JorgeFernandes-Git/ISFM/GUI_ISFM_VisualBasic/GUI RRplano/bin/Debug/img/full-moon.png

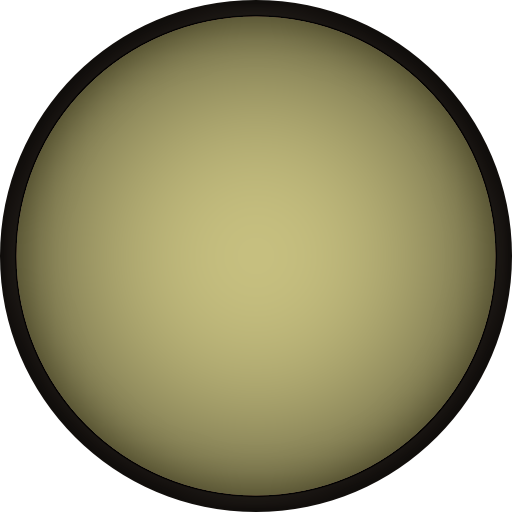
GUI_ISFM_VisualBasic/GUI RRplano/bin/Debug/img/full-moon.png
