JorgeFernandes-Git/ISFM/README.md

# ISFM
Project of the electrical enclosure, motor selection, and programming of the inverse kinematics of an incremental sheet forming machine based on an RR plane robotic arm.

CURRENT VERSIONS

- Final4.0_HK for Arduino
- GUI_ISFM_VisualBasic for sending commands from the computer

Author: Jorge Fernandes 104580
