JorgeFernandes-Git/ISFM/GUI_ISFM_VisualBasic/GUI RRplano/Resources/download.jpg

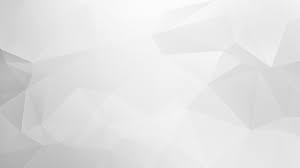
GUI_ISFM_VisualBasic/GUI RRplano/Resources/download.jpg
