JorgeFernandes-Git/ISFM/Electrical_Enclosure_ISFM.pdf

E | E
F | F

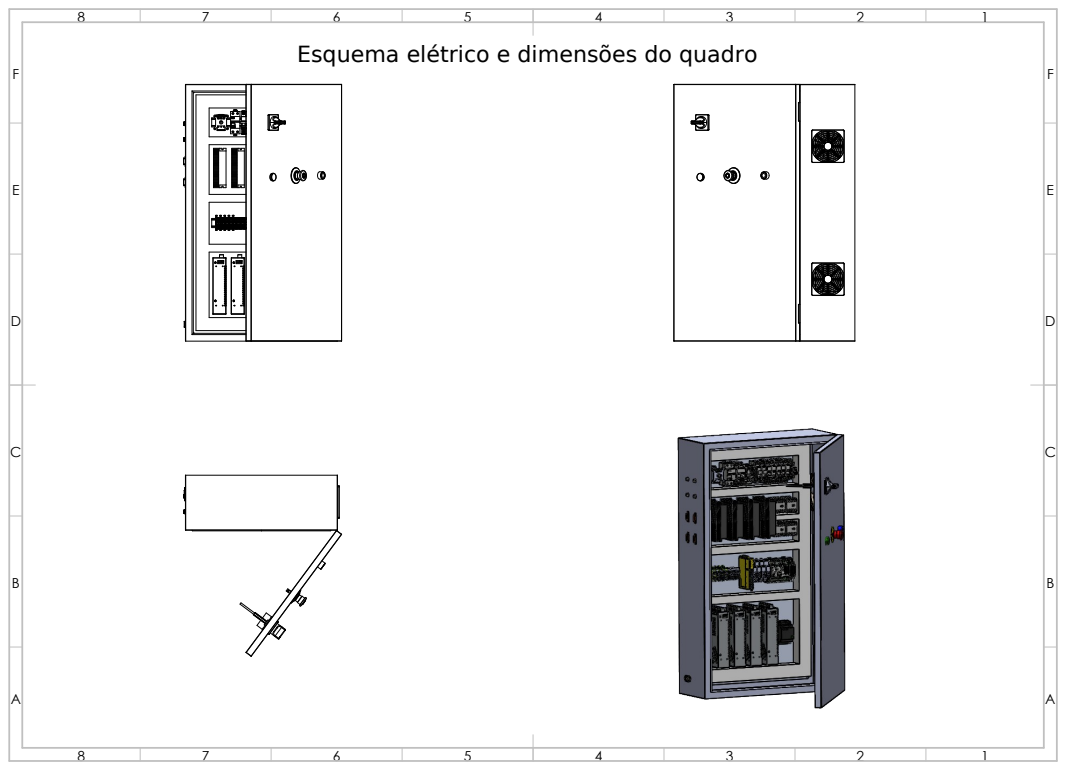
[picture p3: page 1]

Esquema elétrico e dimensões do quadro

1234

5

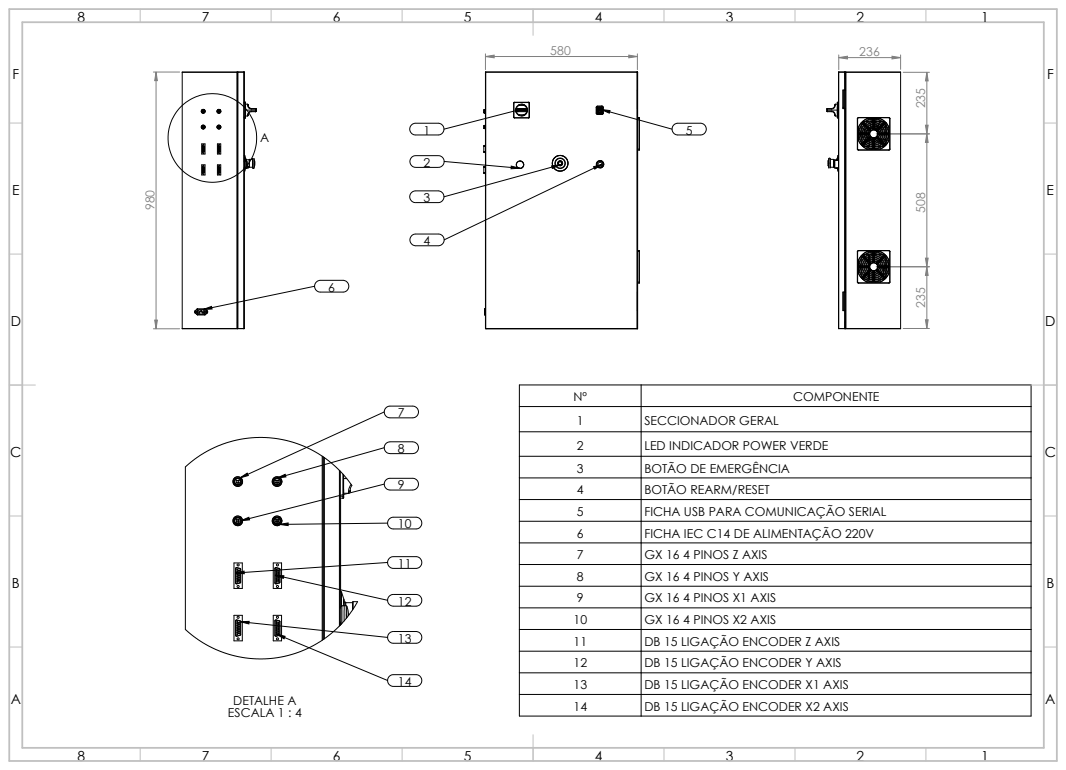
[picture p4: page 2]
DETALHE A ESCALA 1 : 4; COMPONENTE 1; SECCIONADOR GERAL 2; LED INDICADOR POWER VERDE 3; BOTÃO DE EMERGÊNCIA 4; BOTÃO REARM/RESET 5; FICHA USB PARA COMUNICAÇÃO SERIAL 6; FICHA IEC C14 DE ALIMENTAÇÃO 220V 7; GX 16 4 PINOS Z AXIS 8; GX 16 4 PINOS Y AXIS 9; GX 16 4 PINOS X1 AXIS

10 | GX 16 4 PINOS X2 AXIS
11 | DB 15 LIGAÇÃO ENCODER Z AXIS
12 | DB 15 LIGAÇÃO ENCODER Y AXIS
13 | DB 15 LIGAÇÃO ENCODER X1 AXIS
14 | DB 15 LIGAÇÃO ENCODER X2 AXIS

1 | 2 | 3 | 4 | 5 | 6 | 7 | 8 | 9
| | | | | | | | 10

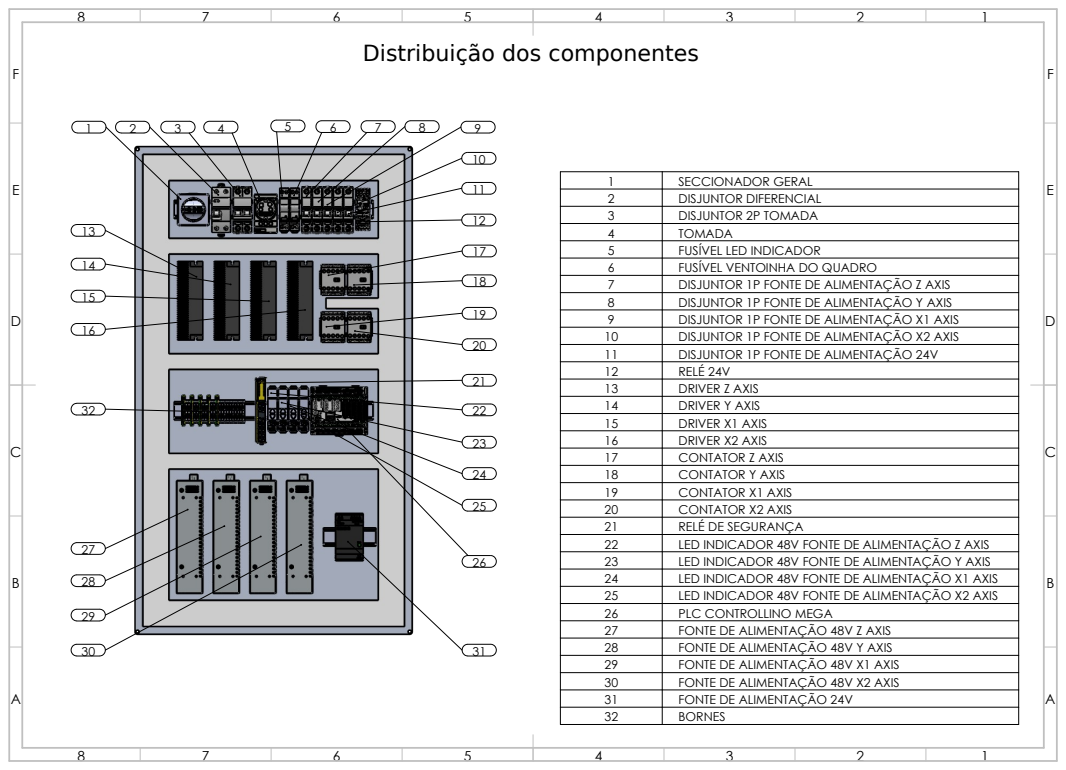
[picture p5: page 3]
RELÉ DE SEGURANÇA

Distribuição dos componentes

1 | SECCIONADOR GERAL
2 | DISJUNTOR DIFERENCIAL
3 | DISJUNTOR 2P TOMADA
4 | TOMADA
5 | FUSÍVEL LED INDICADOR
6 | FUSÍVEL VENTOINHA DO QUADRO
7 | DISJUNTOR 1P FONTE DE ALIMENTAÇÃO Z AXIS
8 | DISJUNTOR 1P FONTE DE ALIMENTAÇÃO Y AXIS
9 | DISJUNTOR 1P FONTE DE ALIMENTAÇÃO X1 AXIS
10 | DISJUNTOR 1P FONTE DE ALIMENTAÇÃO X2 AXIS
11 | DISJUNTOR 1P FONTE DE ALIMENTAÇÃO 24V
12 | RELÉ 24V
13 | DRIVER Z AXIS
14 | DRIVER Y AXIS
15 | DRIVER X1 AXIS
16 | DRIVER X2 AXIS
17 | CONTATOR Z AXIS
18 | CONTATOR Y AXIS
19 | CONTATOR X1 AXIS
20 | CONTATOR X2 AXIS

22 | LED INDICADOR 48V FONTE DE ALIMENTAÇÃO Z AXIS
23 | LED INDICADOR 48V FONTE DE ALIMENTAÇÃO Y AXIS
24 | LED INDICADOR 48V FONTE DE ALIMENTAÇÃO X1 AXIS
25 | LED INDICADOR 48V FONTE DE ALIMENTAÇÃO X2 AXIS
26 | PLC CONTROLLINO MEGA
27 | FONTE DE ALIMENTAÇÃO 48V Z AXIS
28 | FONTE DE ALIMENTAÇÃO 48V Y AXIS
29 | FONTE DE ALIMENTAÇÃO 48V X1 AXIS
30 | FONTE DE ALIMENTAÇÃO 48V X2 AXIS
31 | FONTE DE ALIMENTAÇÃO 24V
32 | BORNES

380.00
70

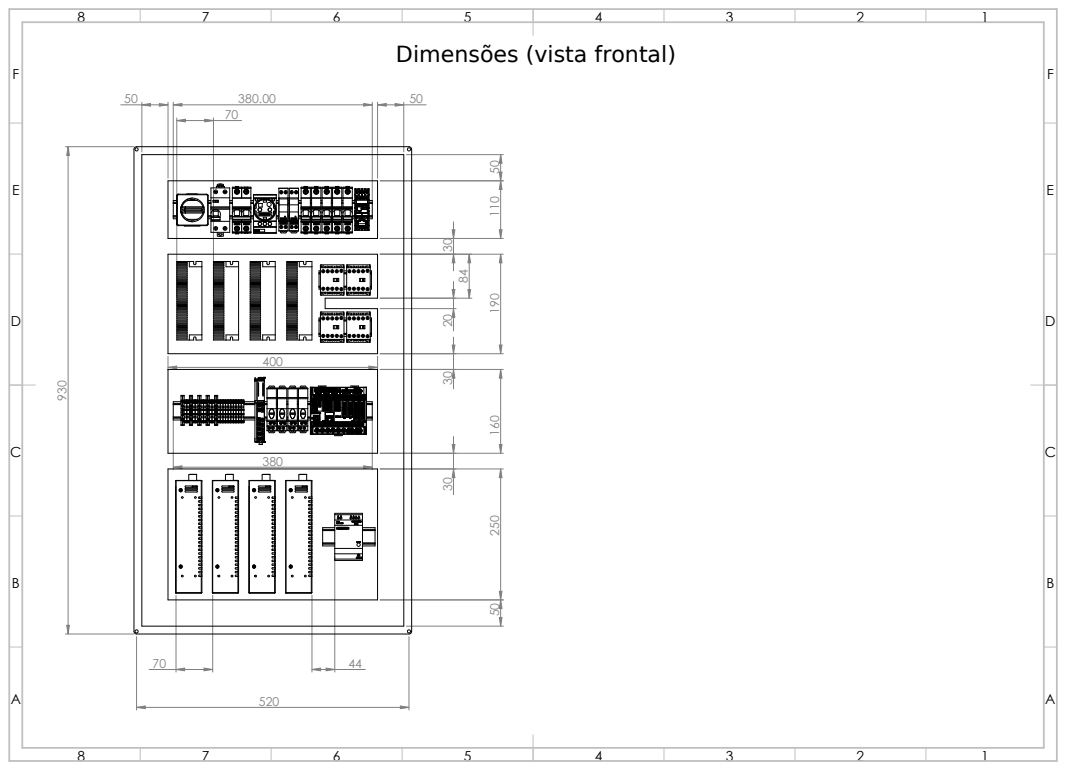
[picture p6: page 4]

Dimensões (vista frontal)

# Esquema de Potência 1

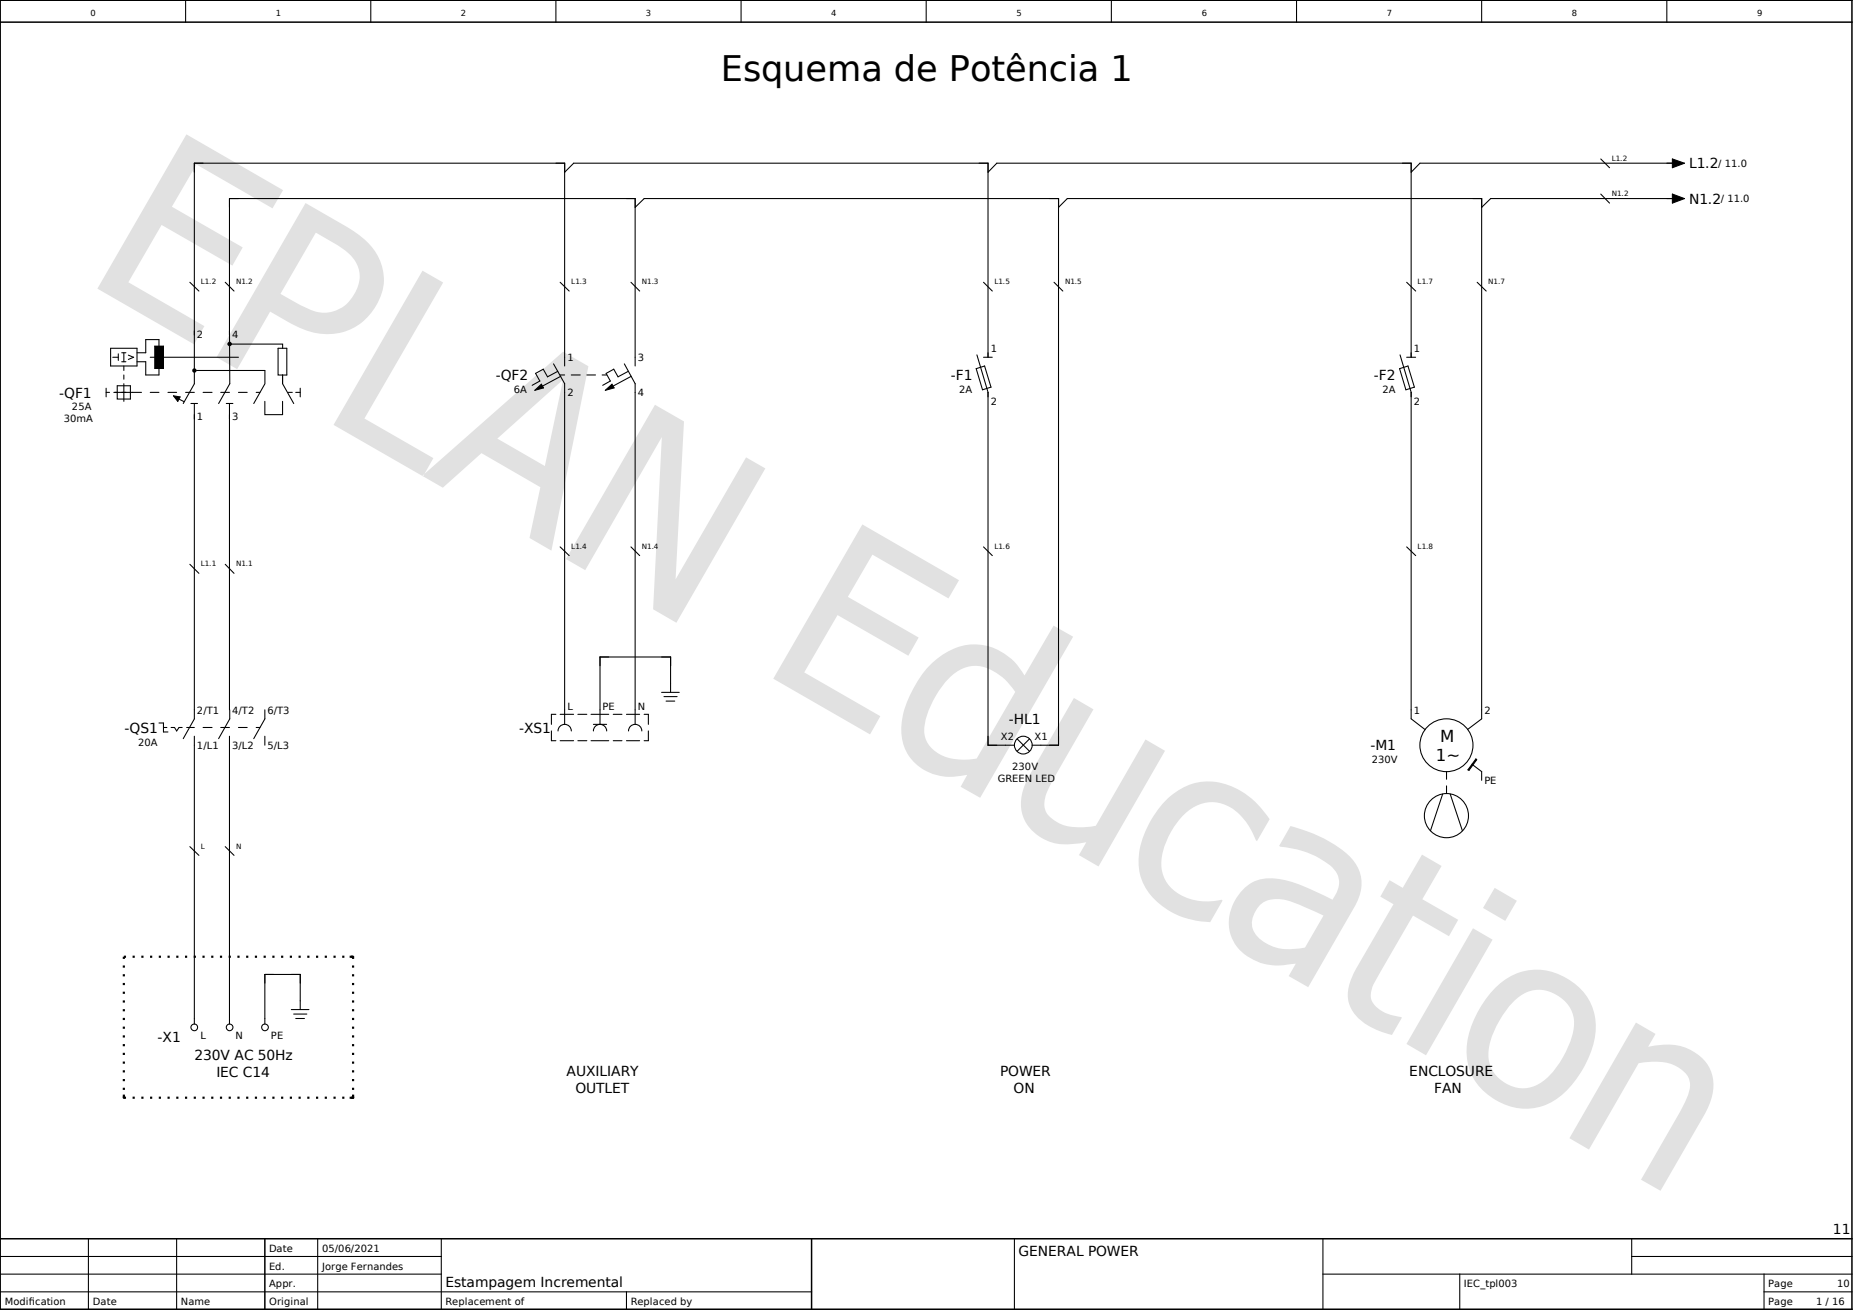
[picture p7: page 5]
IEC C14; AUXILIARY; OUTLET; ENCLOSURE FAN; POWER ON; 230V GREEN LED

Estampagem Incremental | GENERAL POWER

Ed. | Jorge Fernandes
Appr. | | | | IEC_tpl003 | Page

Modification | Date | Name | Original | | Replacement of | Replaced by

# Esquema de Potência 2

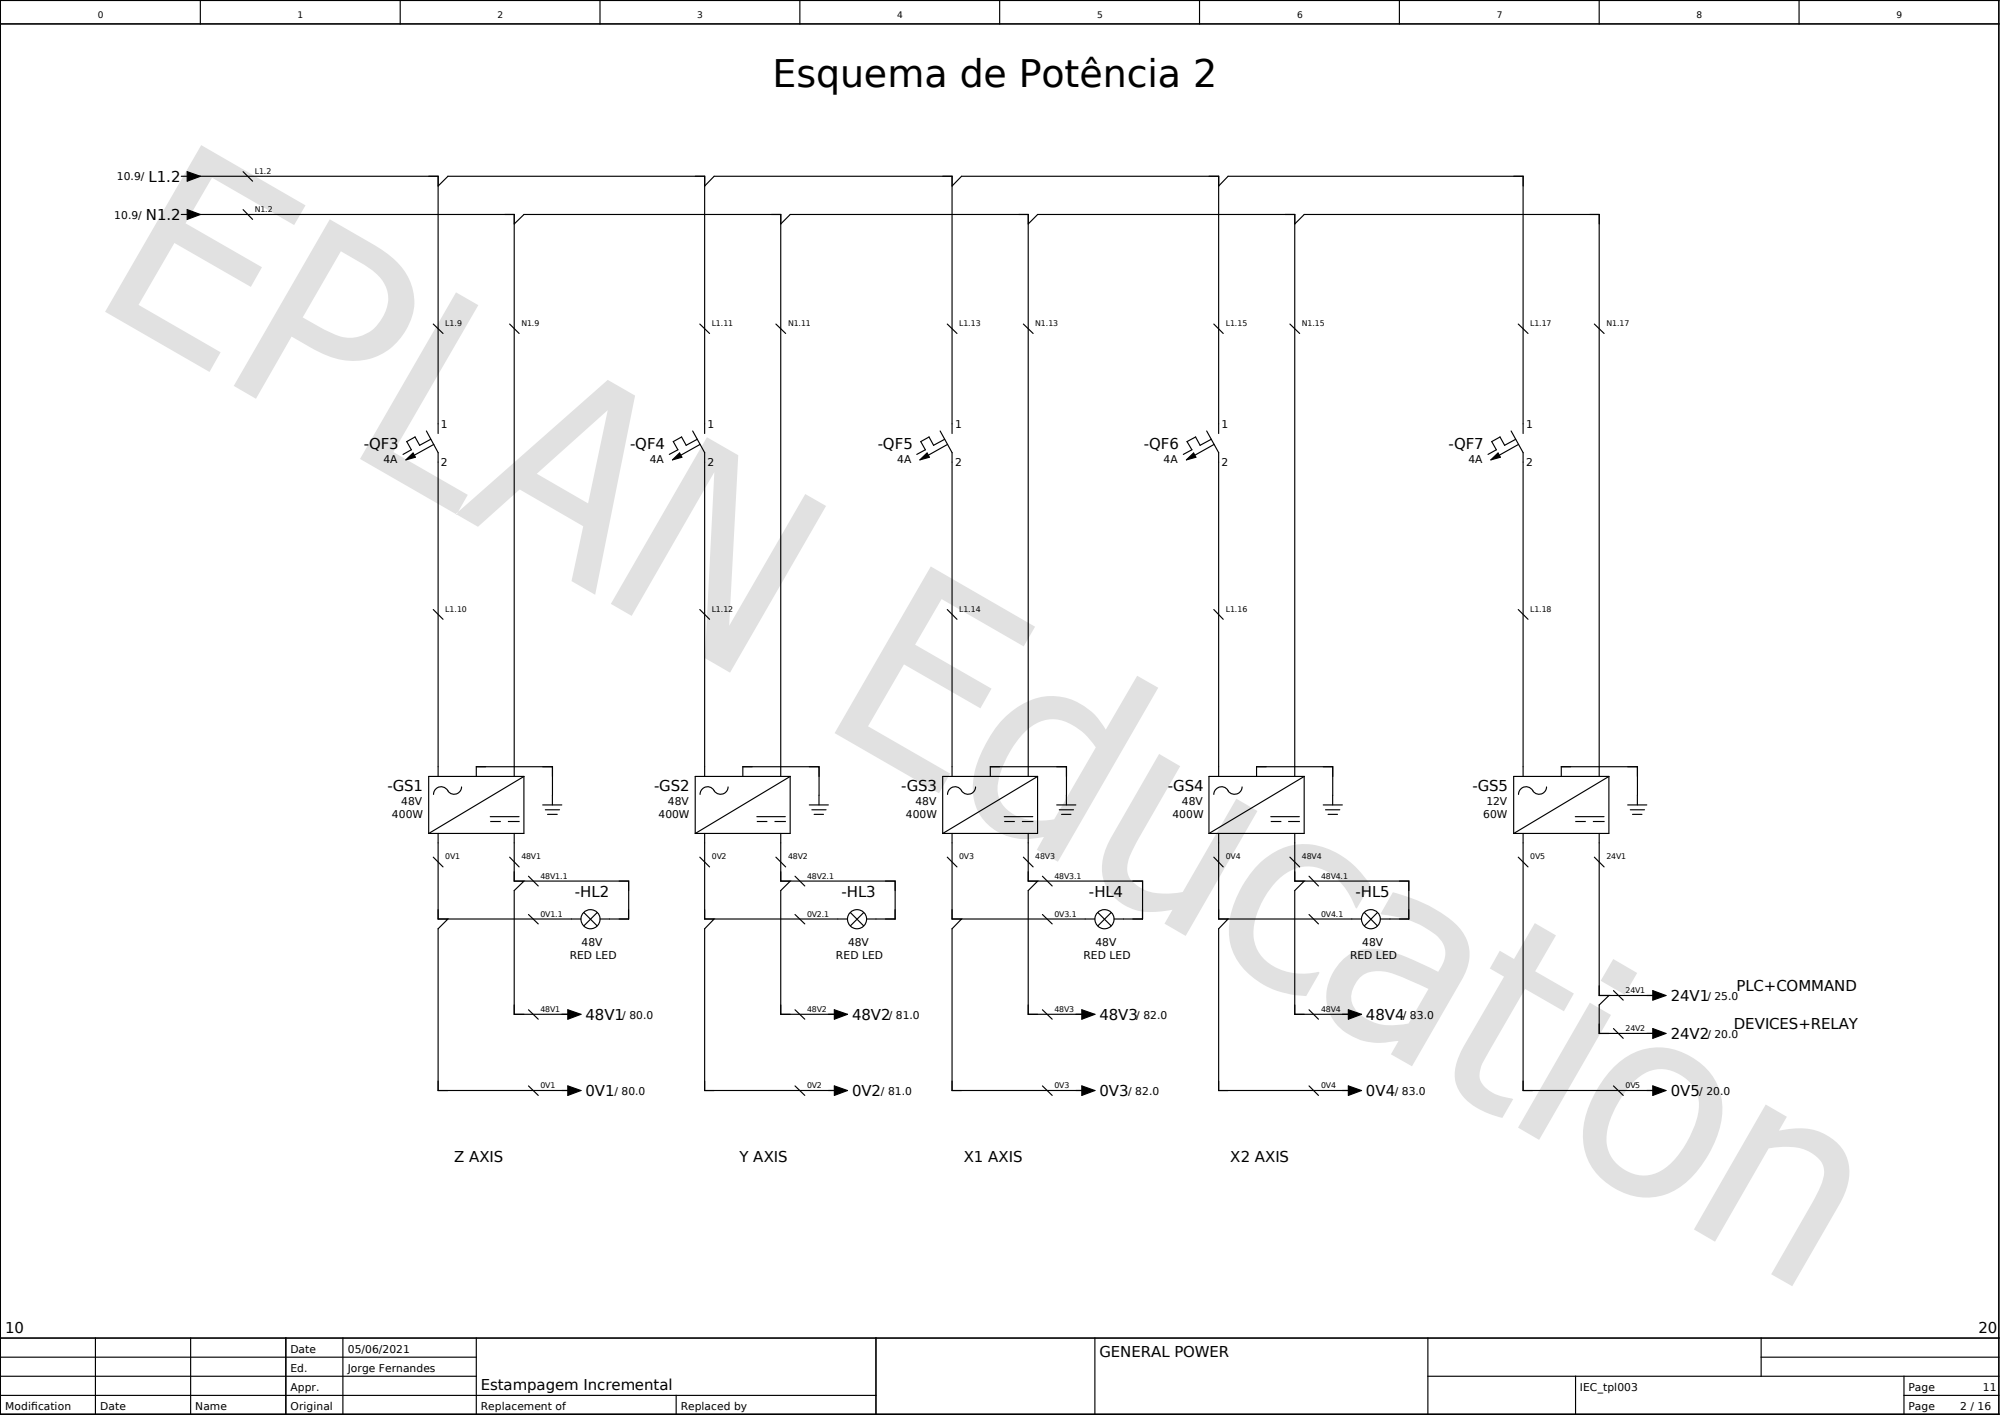
[picture p8: page 6]
GENERAL POWER; Z AXIS; Y AXIS; X1 AXIS; X2 AXIS; PLC+COMMAND; DEVICES+RELAY; 48V RED LED

# Caixa de comando

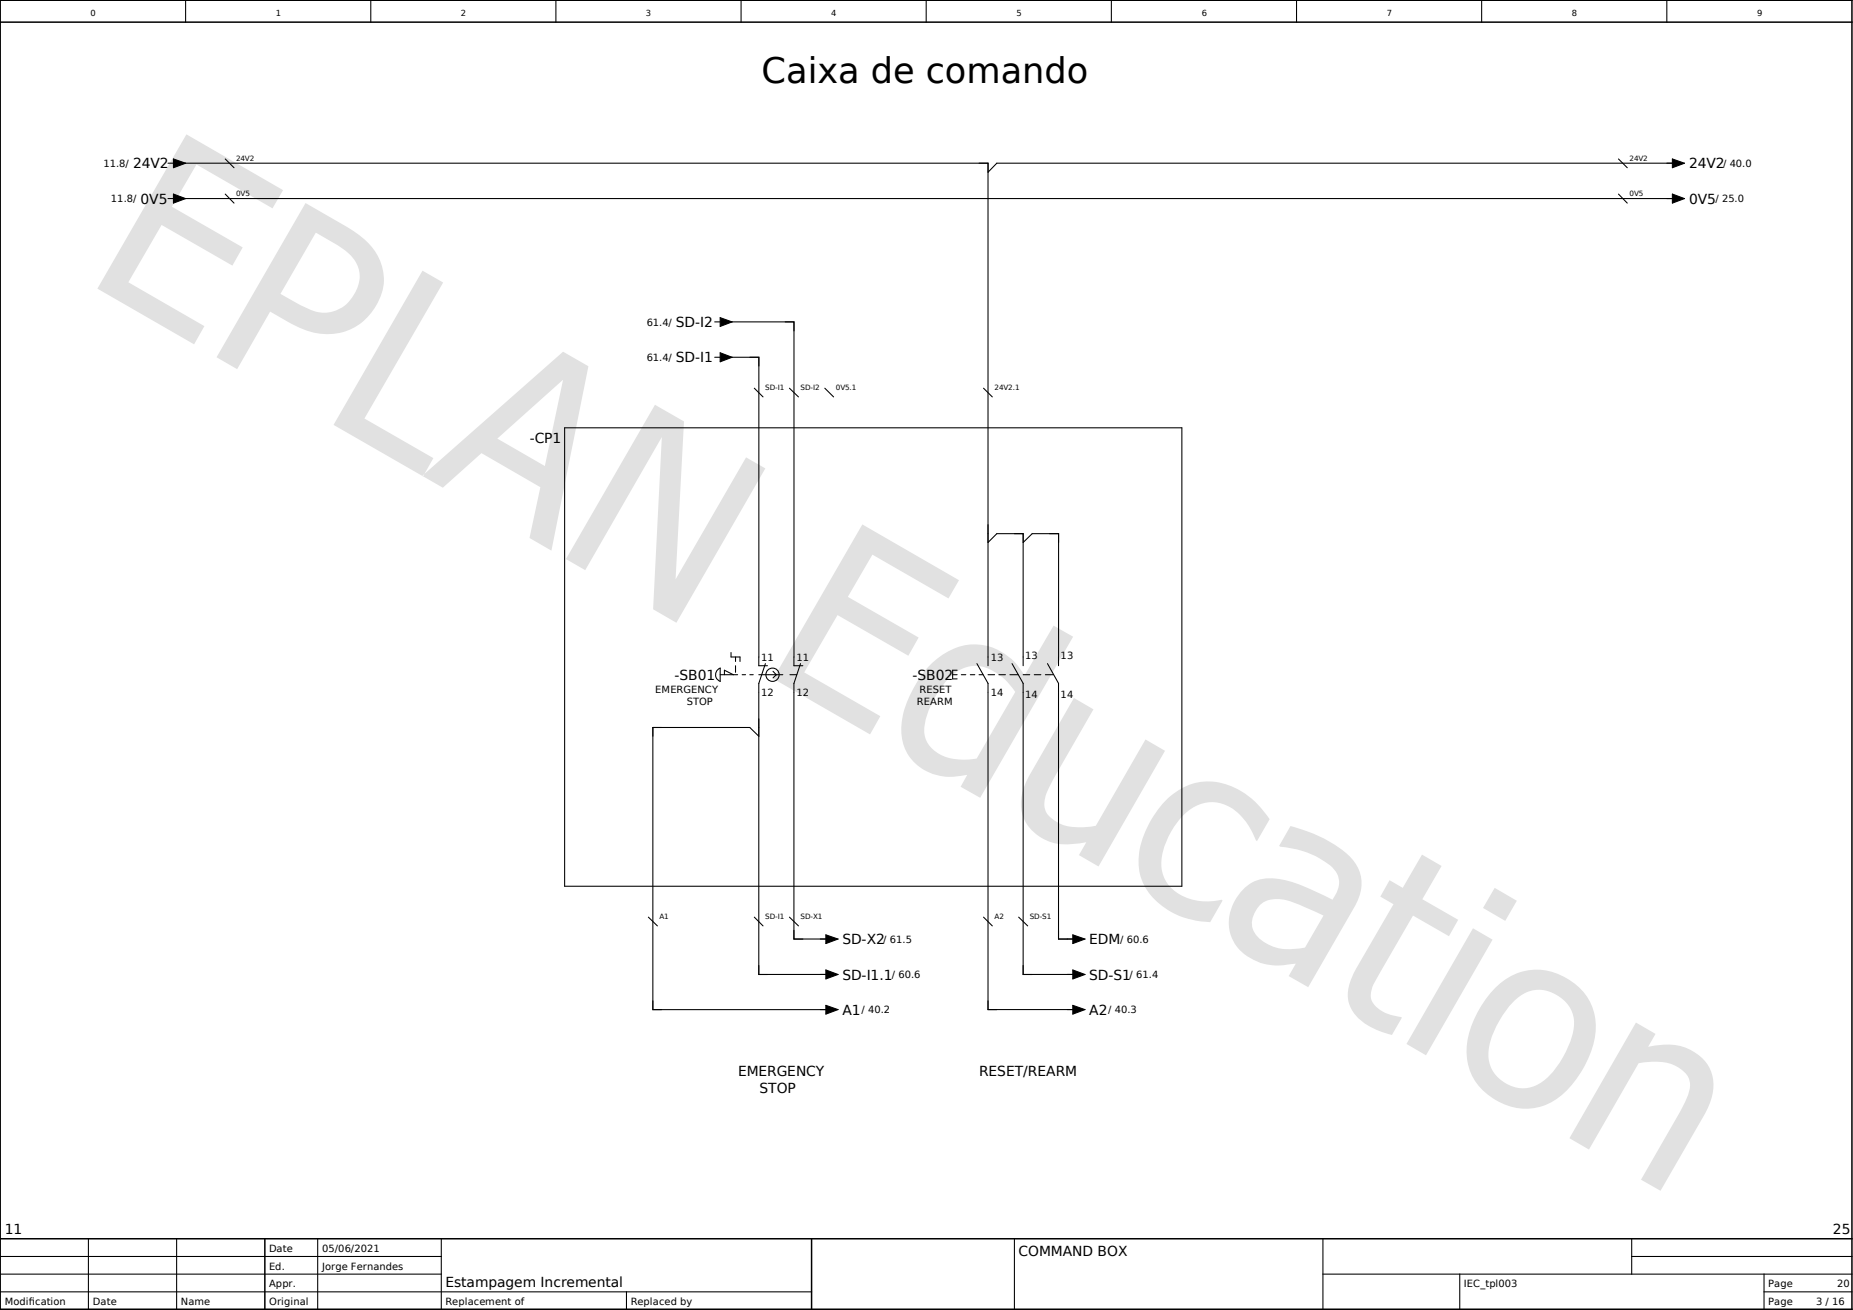
[picture p9: page 7]
COMMAND BOX; EMERGENCY STOP; RESET/REARM; RESET REARM; EDM/ 60.6

# Alimentação controlador

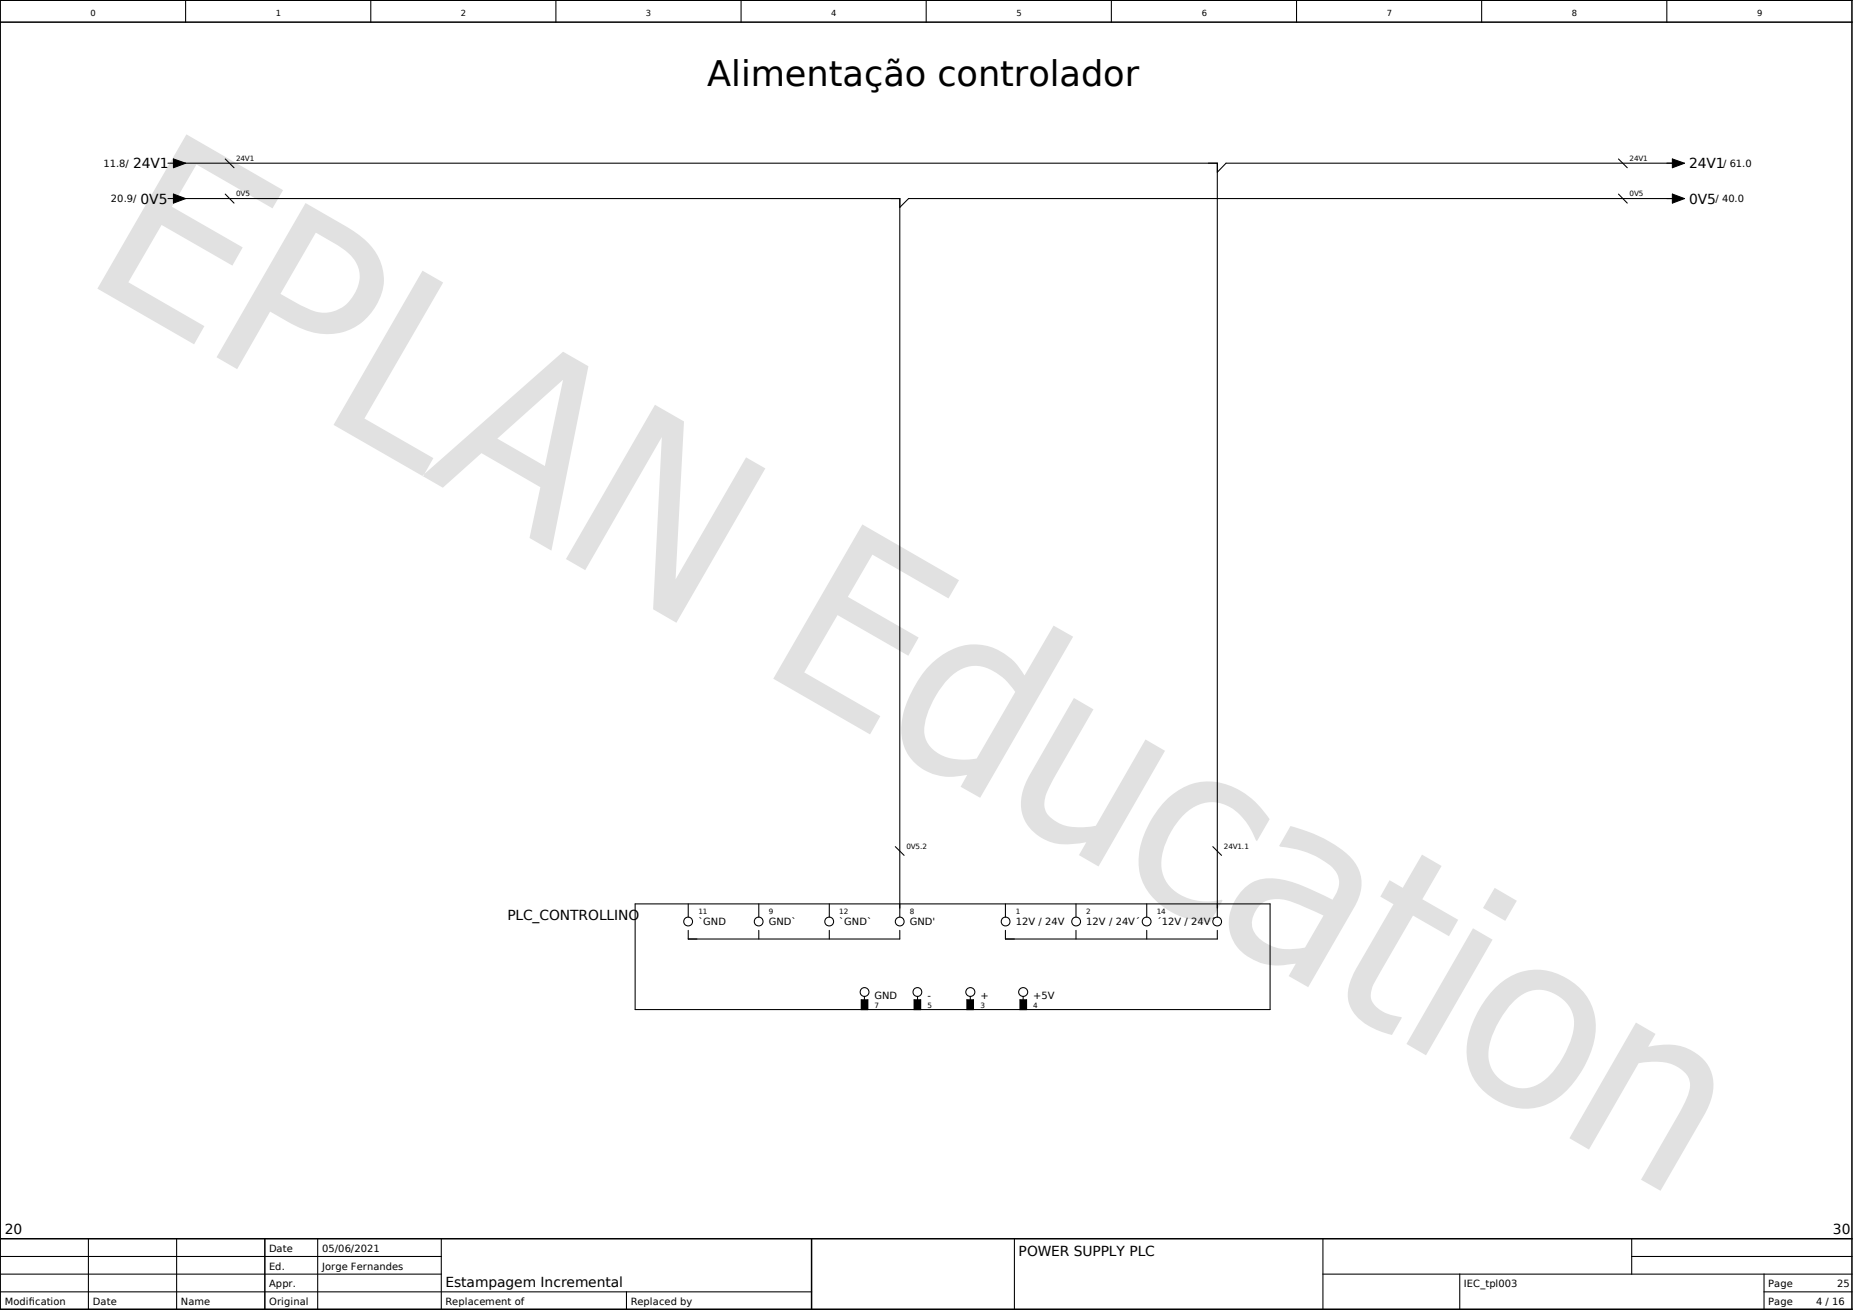
[picture p10: page 8]
PLC_CONTROLLINO; `GND; GND`; `GND`; GND'; GND

POWER SUPPLY PLC

# Controlador

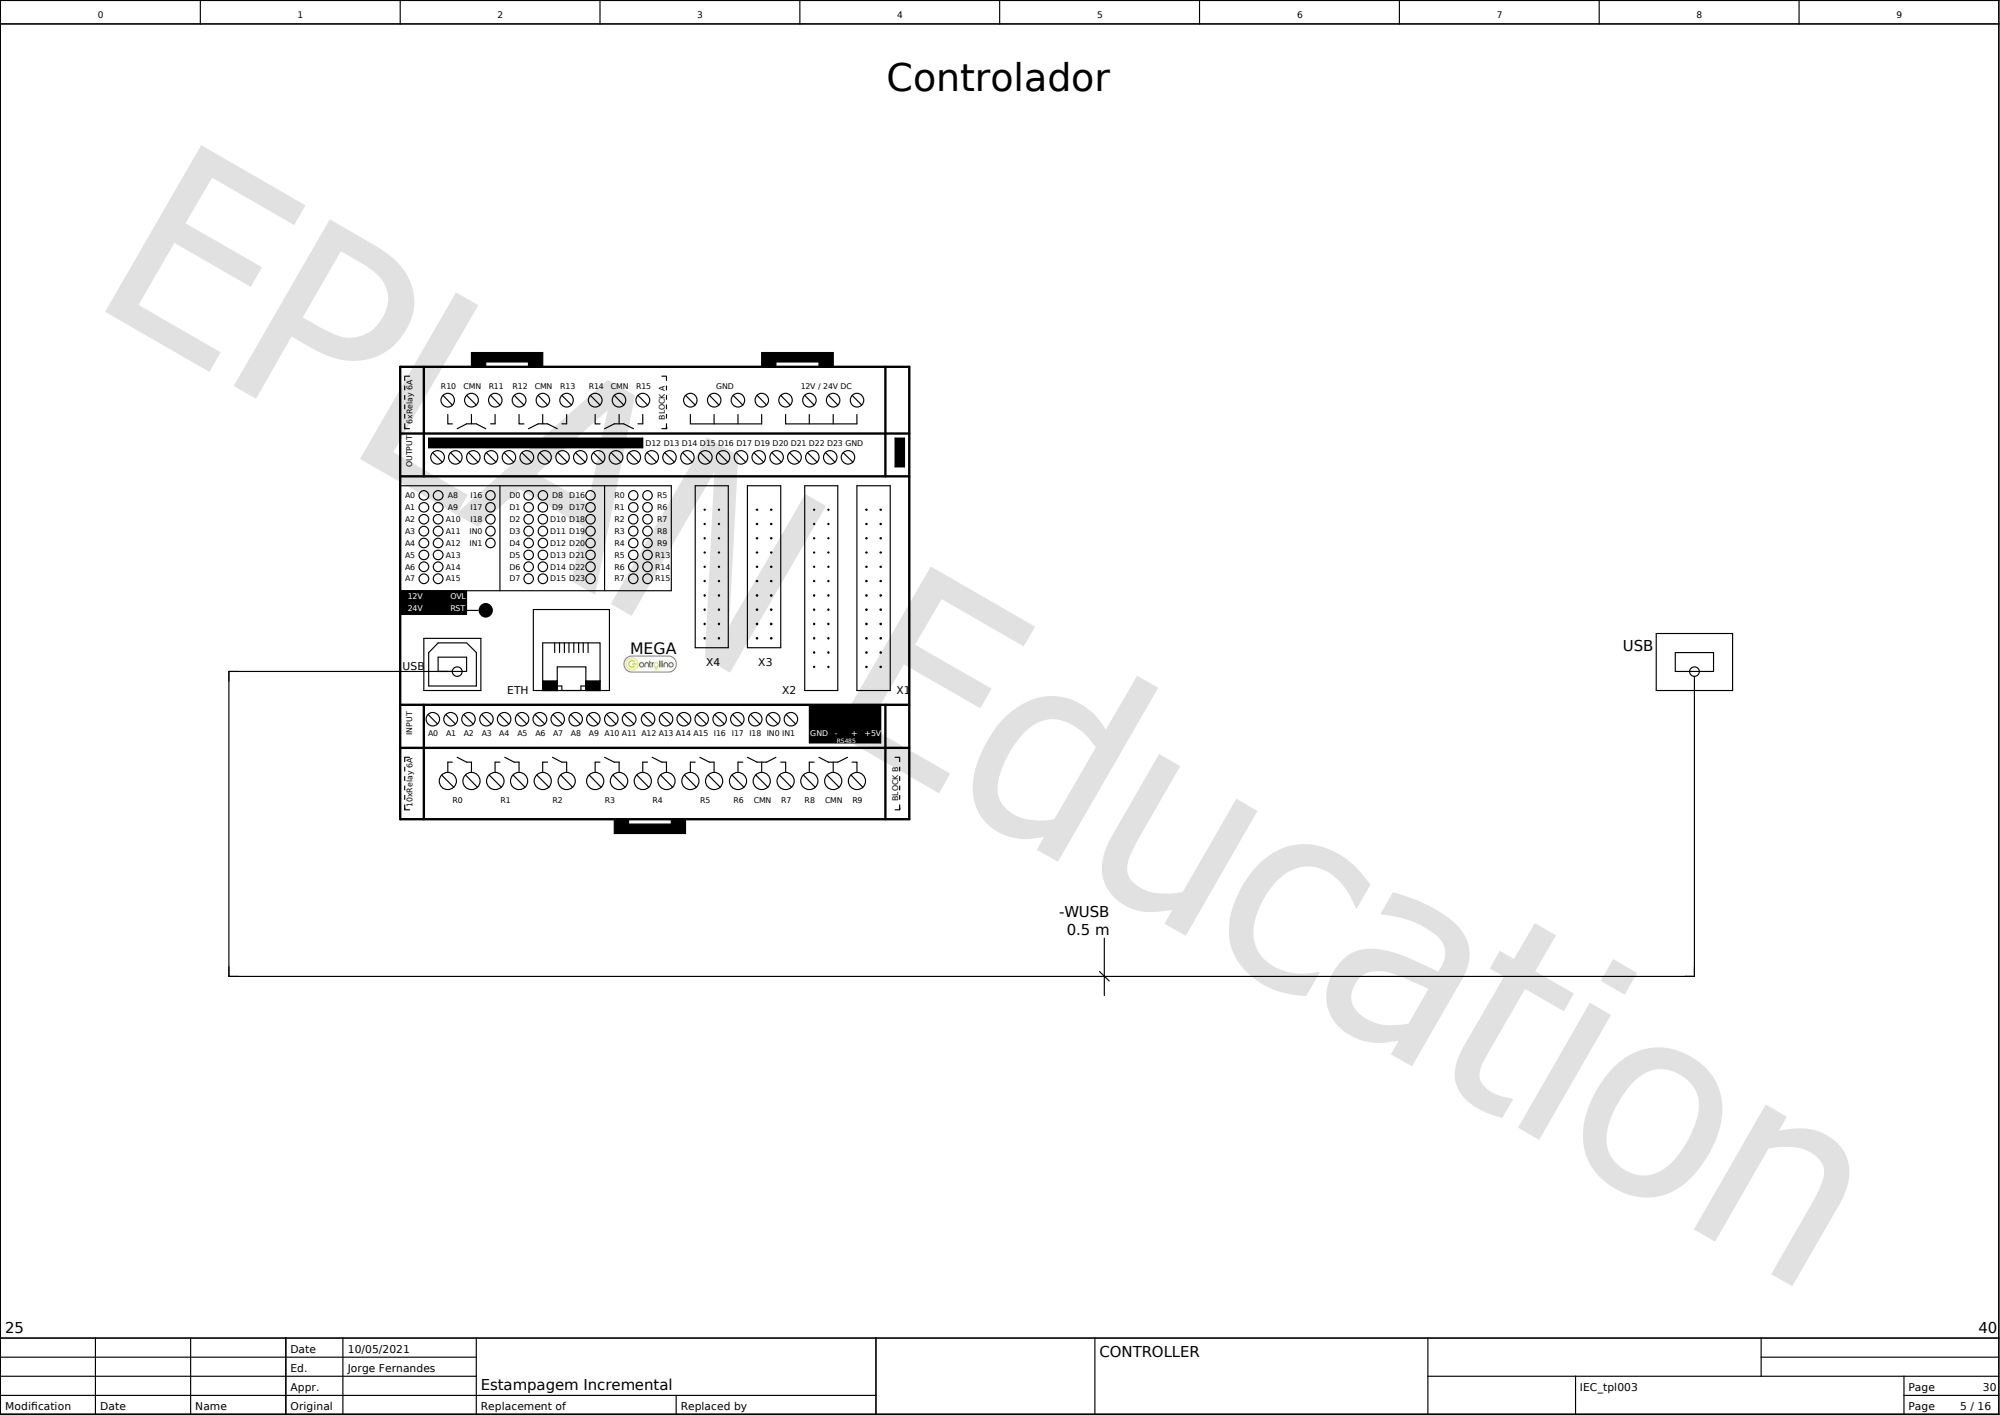
[picture p11: page 9]

A0 A1 A2 A3 A4 A5 A6 A7 A8 A9 A10 A11 A12 A13 A14 A15 I16 I17 I18 IN0 IN1 | GND -+ +5V RS485

R0 R1 R2 R3 R4 R5 R6 CMN R7 R8 CMN R9

# Entradas 1

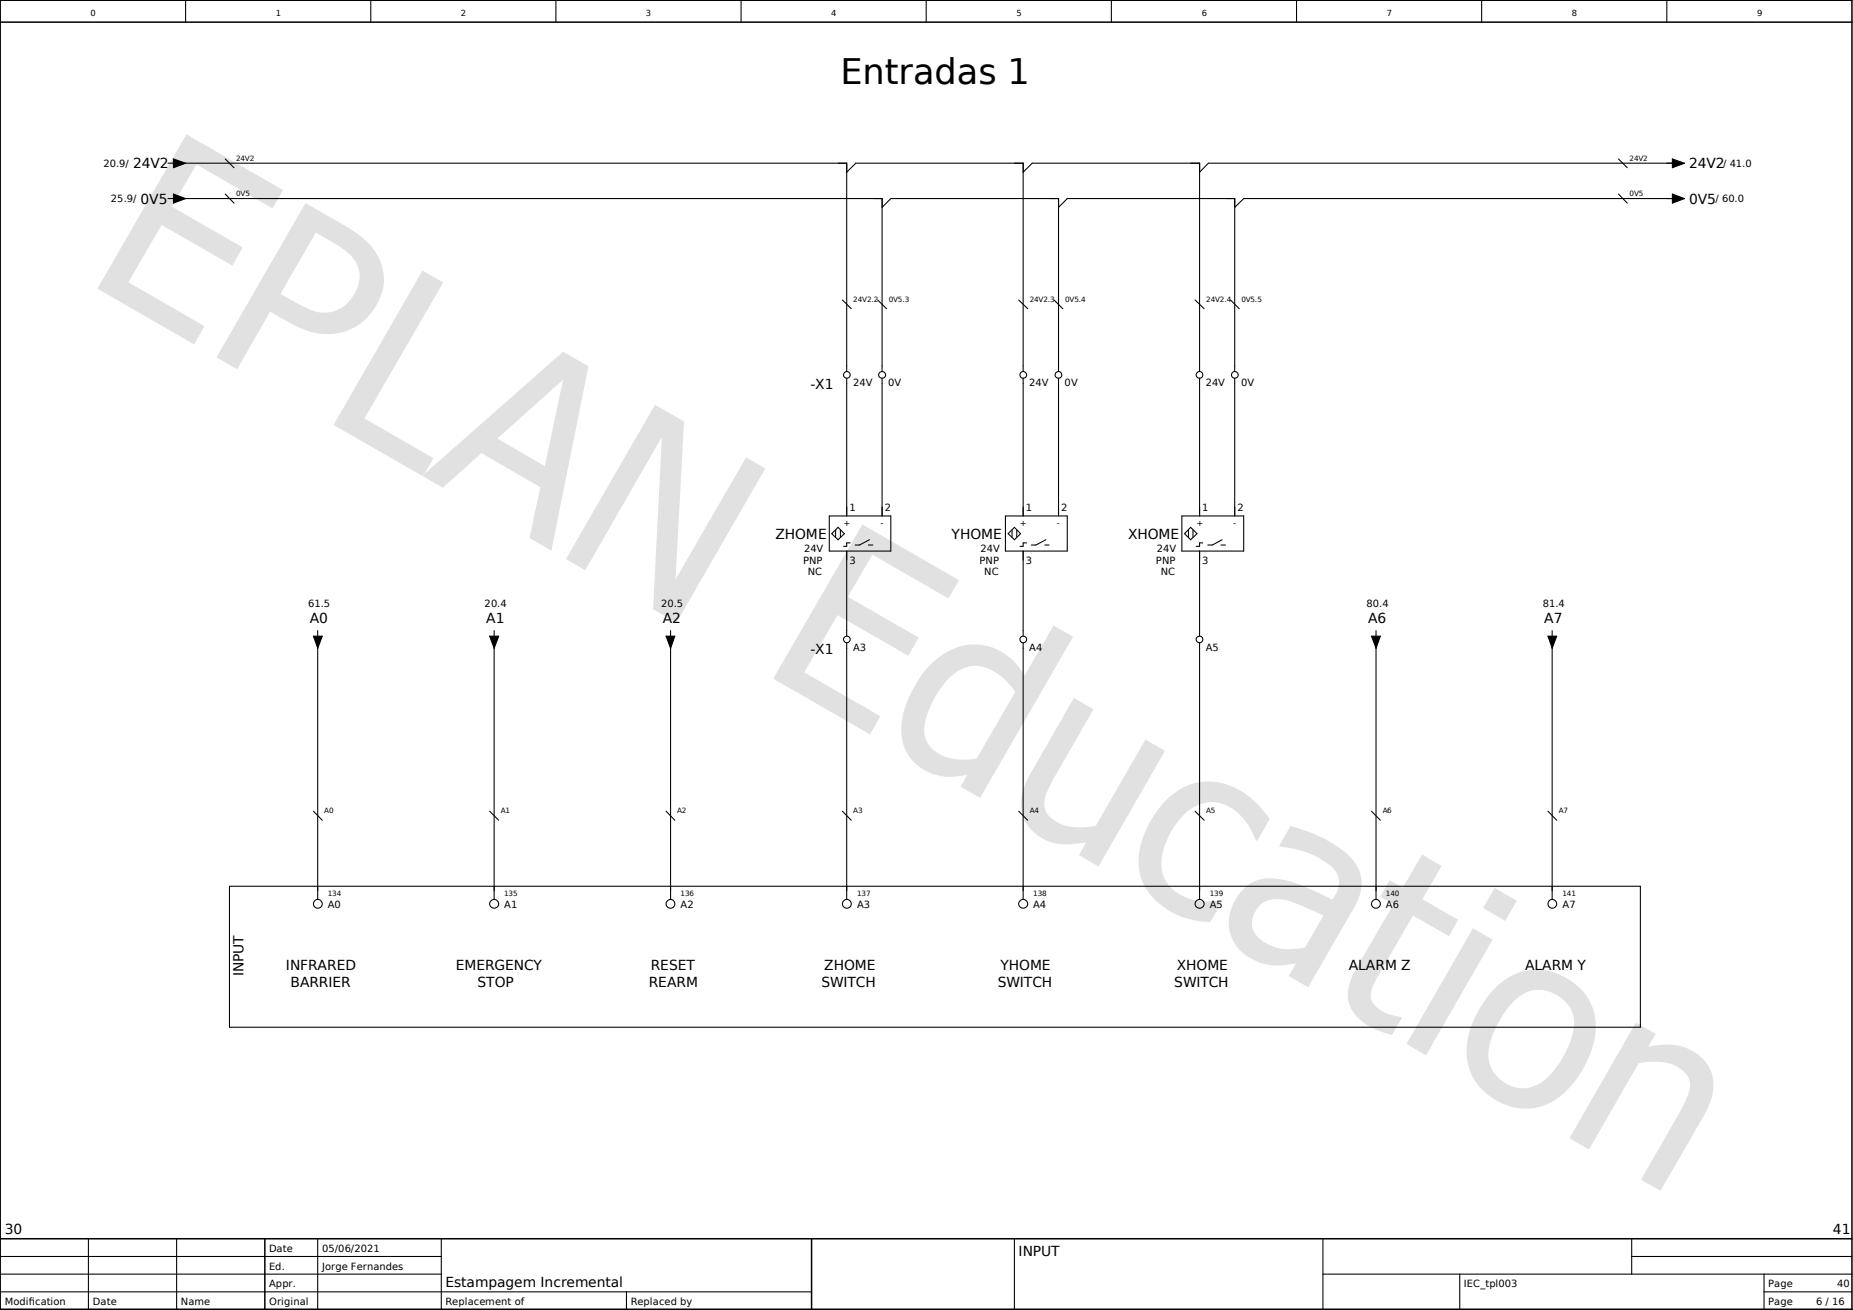
[picture p12: page 10]
INPUT; INFRARED BARRIER; EMERGENCY STOP; RESET REARM; ZHOME SWITCH; YHOME SWITCH; XHOME SWITCH; ALARM Z; ALARM Y; ZHOME 24V PNP NC; YHOME 24V PNP NC; XHOME 24V PNP NC

# Entradas 2

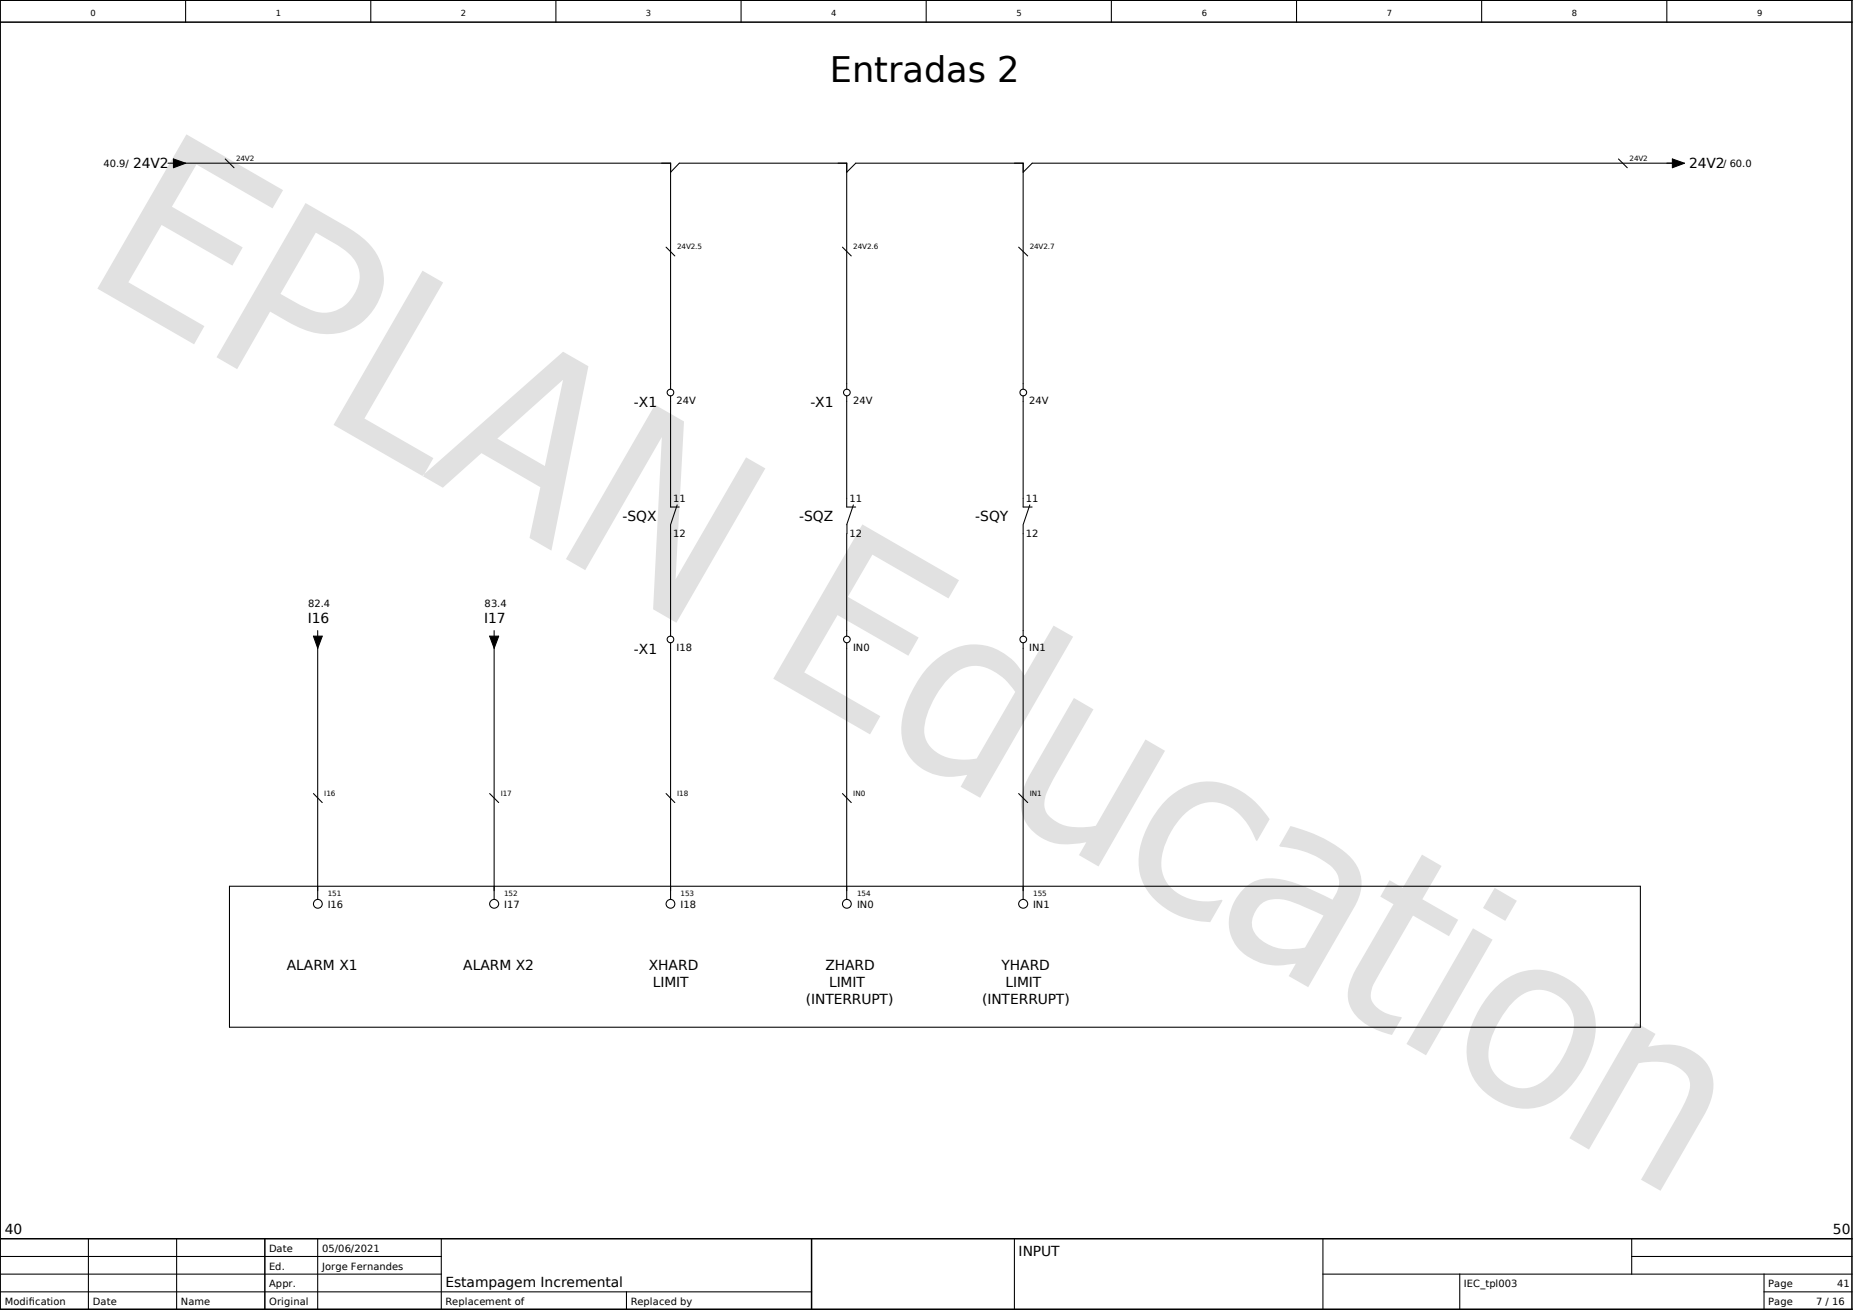
[picture p13: page 11]
INPUT; XHARD LIMIT; ZHARD LIMIT (INTERRUPT); YHARD LIMIT (INTERRUPT); ALARM X1; ALARM X2; -SQZ; -SQY; -SQX

# Saídas 1

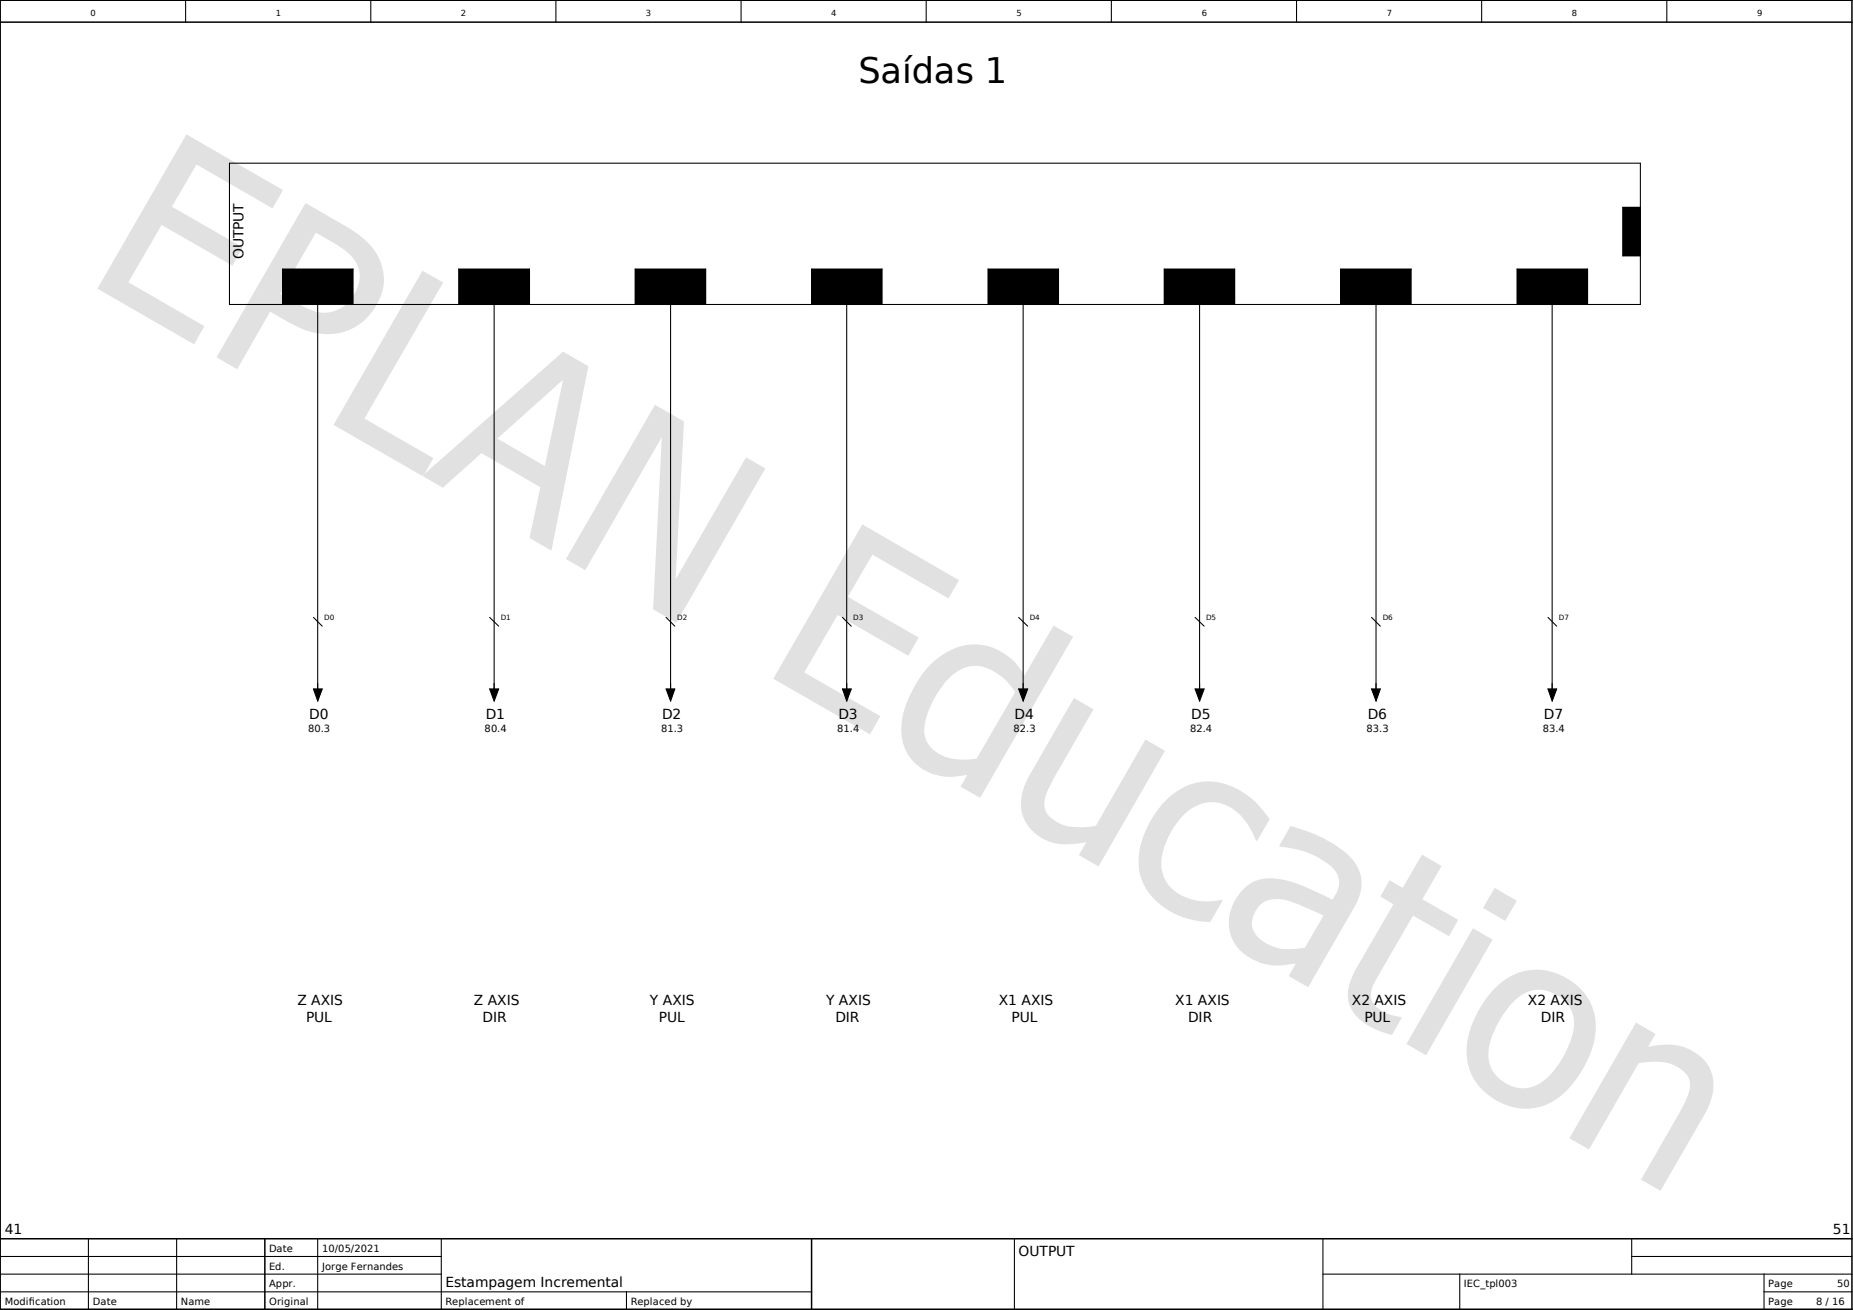
[picture p14: page 12]

# Saídas 2

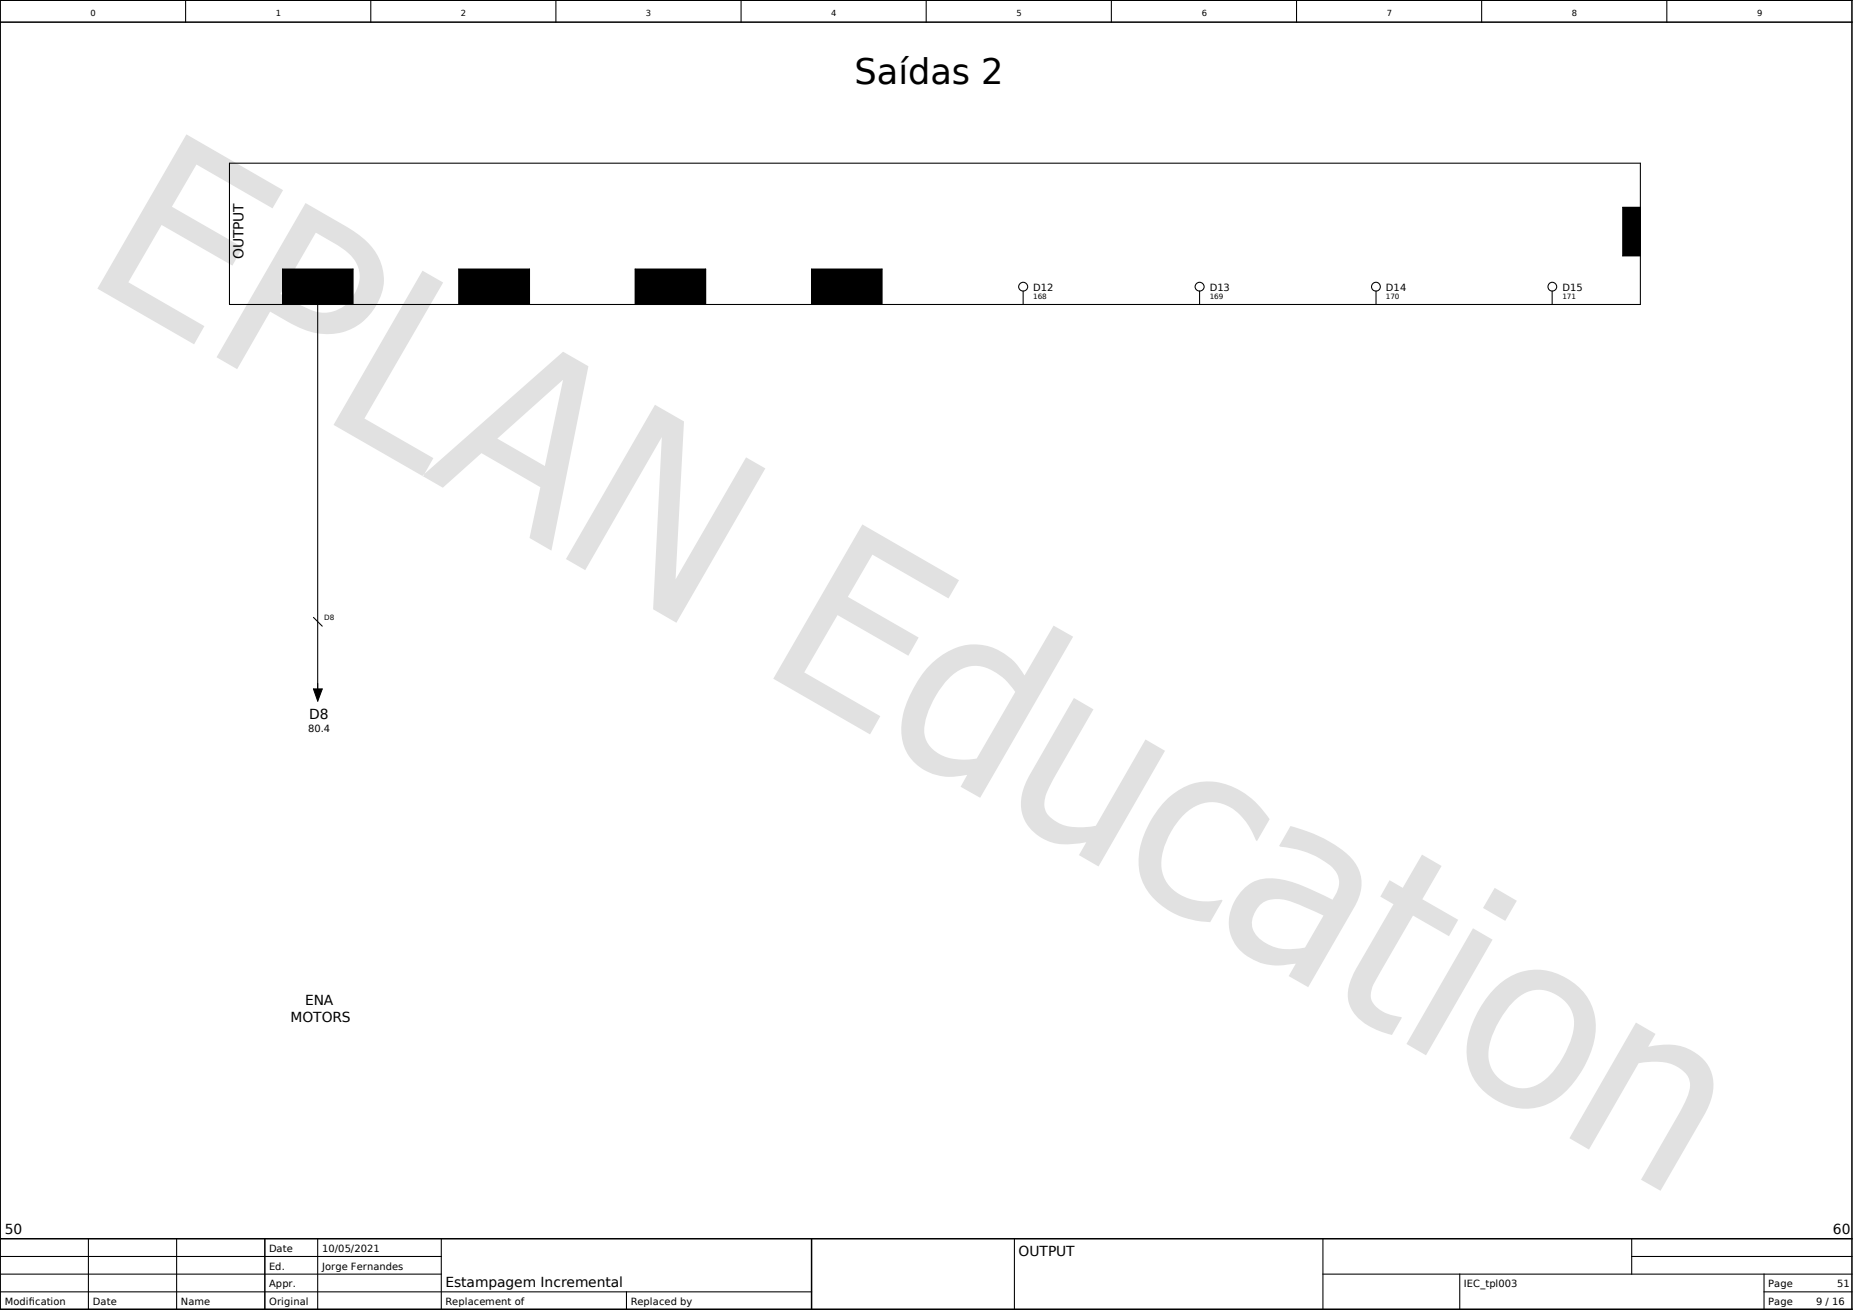
[picture p15: page 13]

# Barreira imaterial

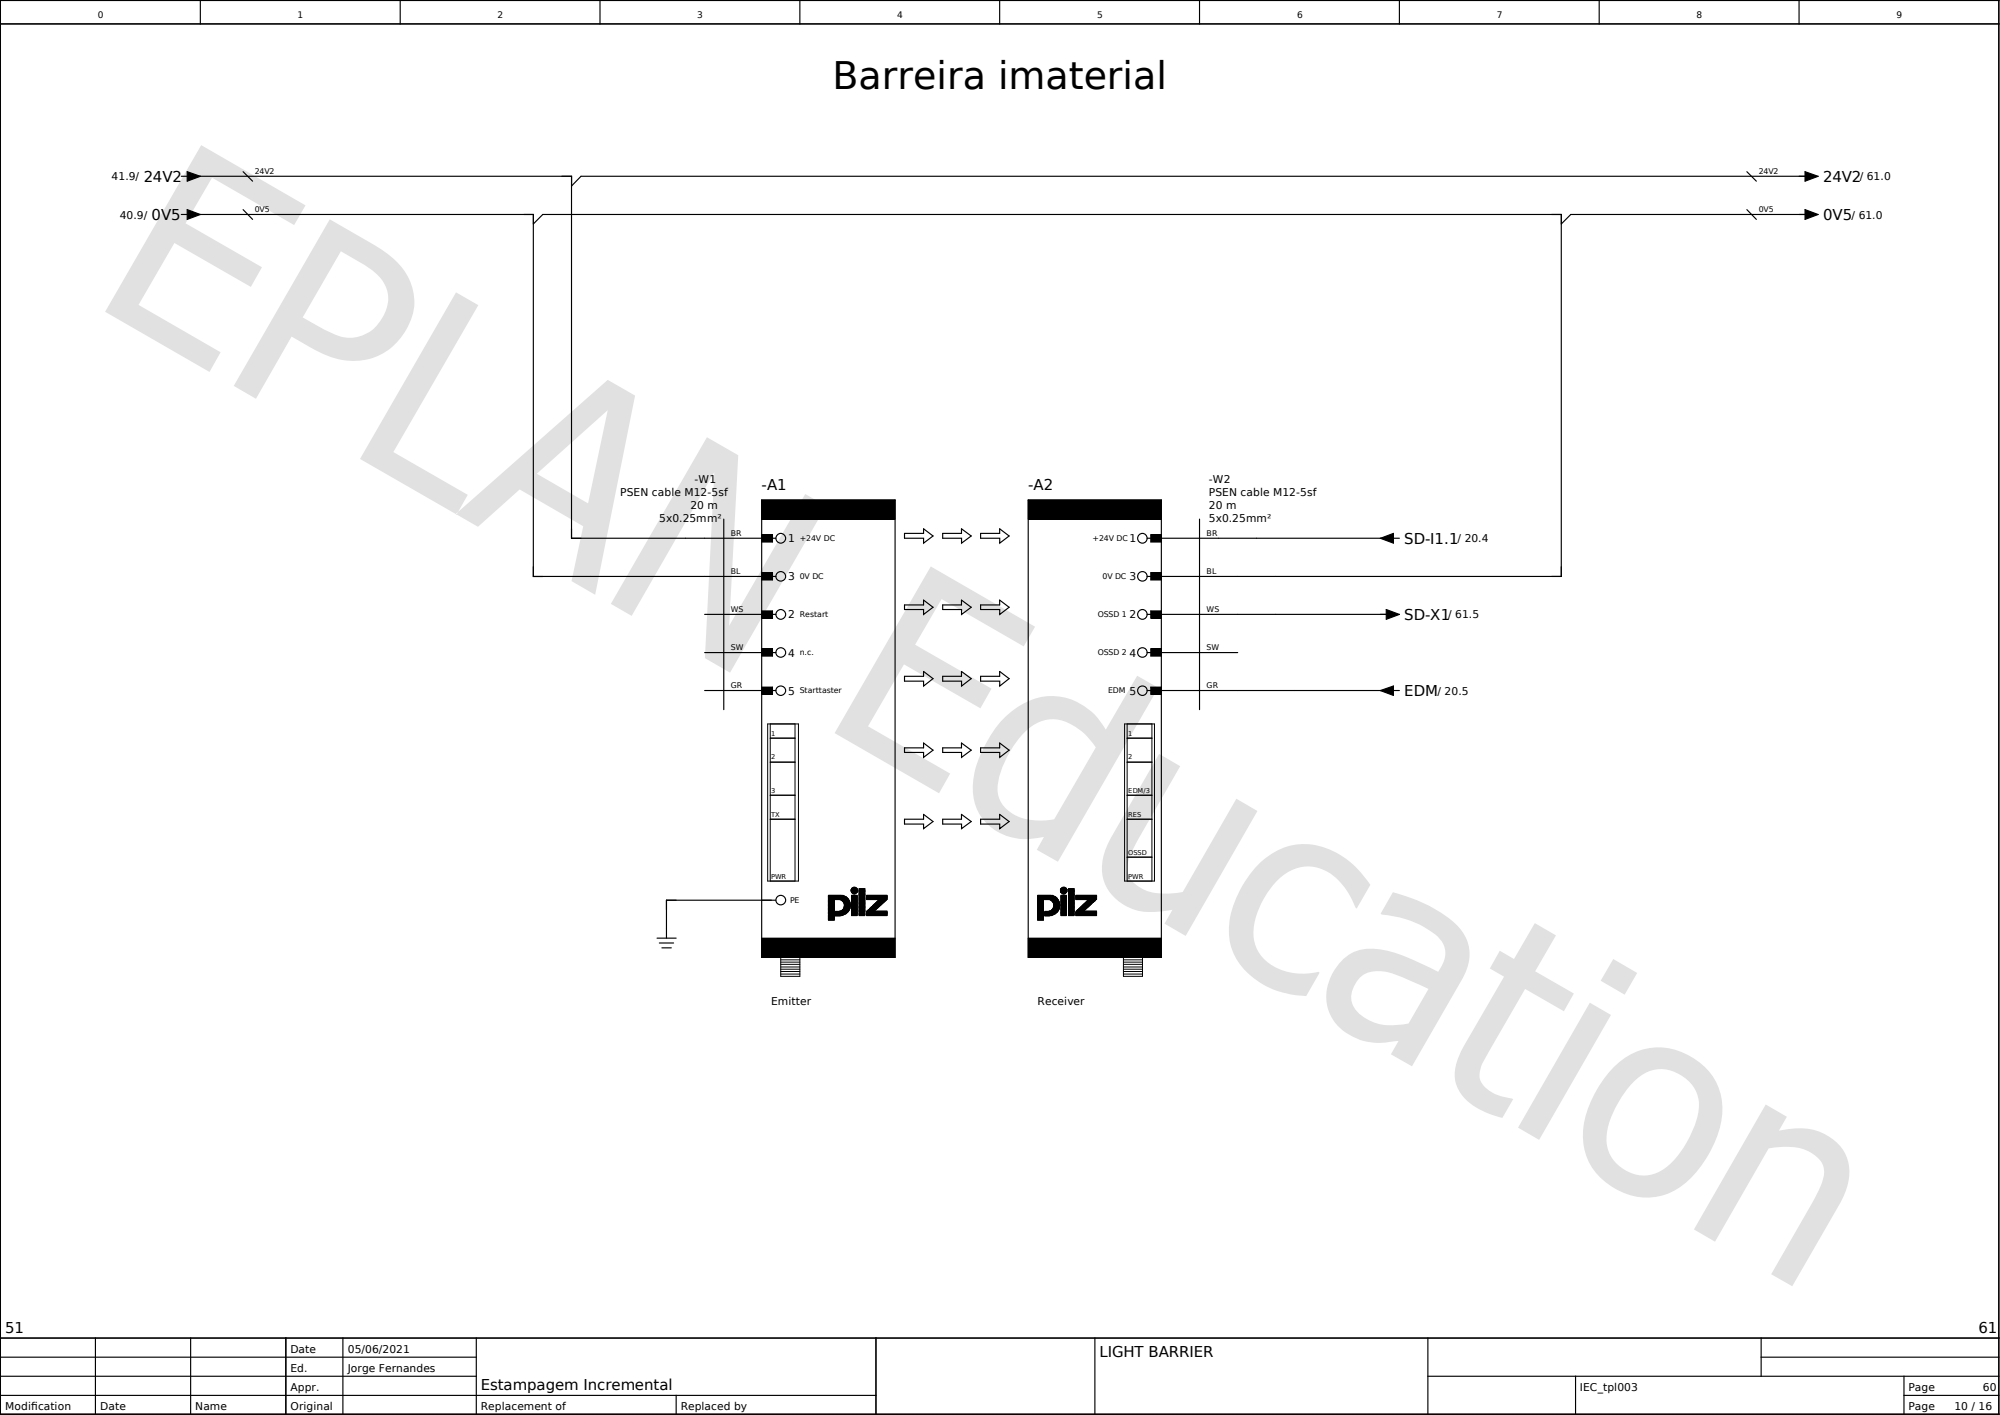
[picture p16: page 14]
LIGHT BARRIER; Emitter; 2 Restart; 5 Starttaster; Receiver; EDM 5; OSSD 2 4; OSSD 1 2; EDM/3; RES; OSSD; PWR; 5x0.25mm²; PSEN cable M12-5sf; EDM/ 20.5

# Relé de segurança

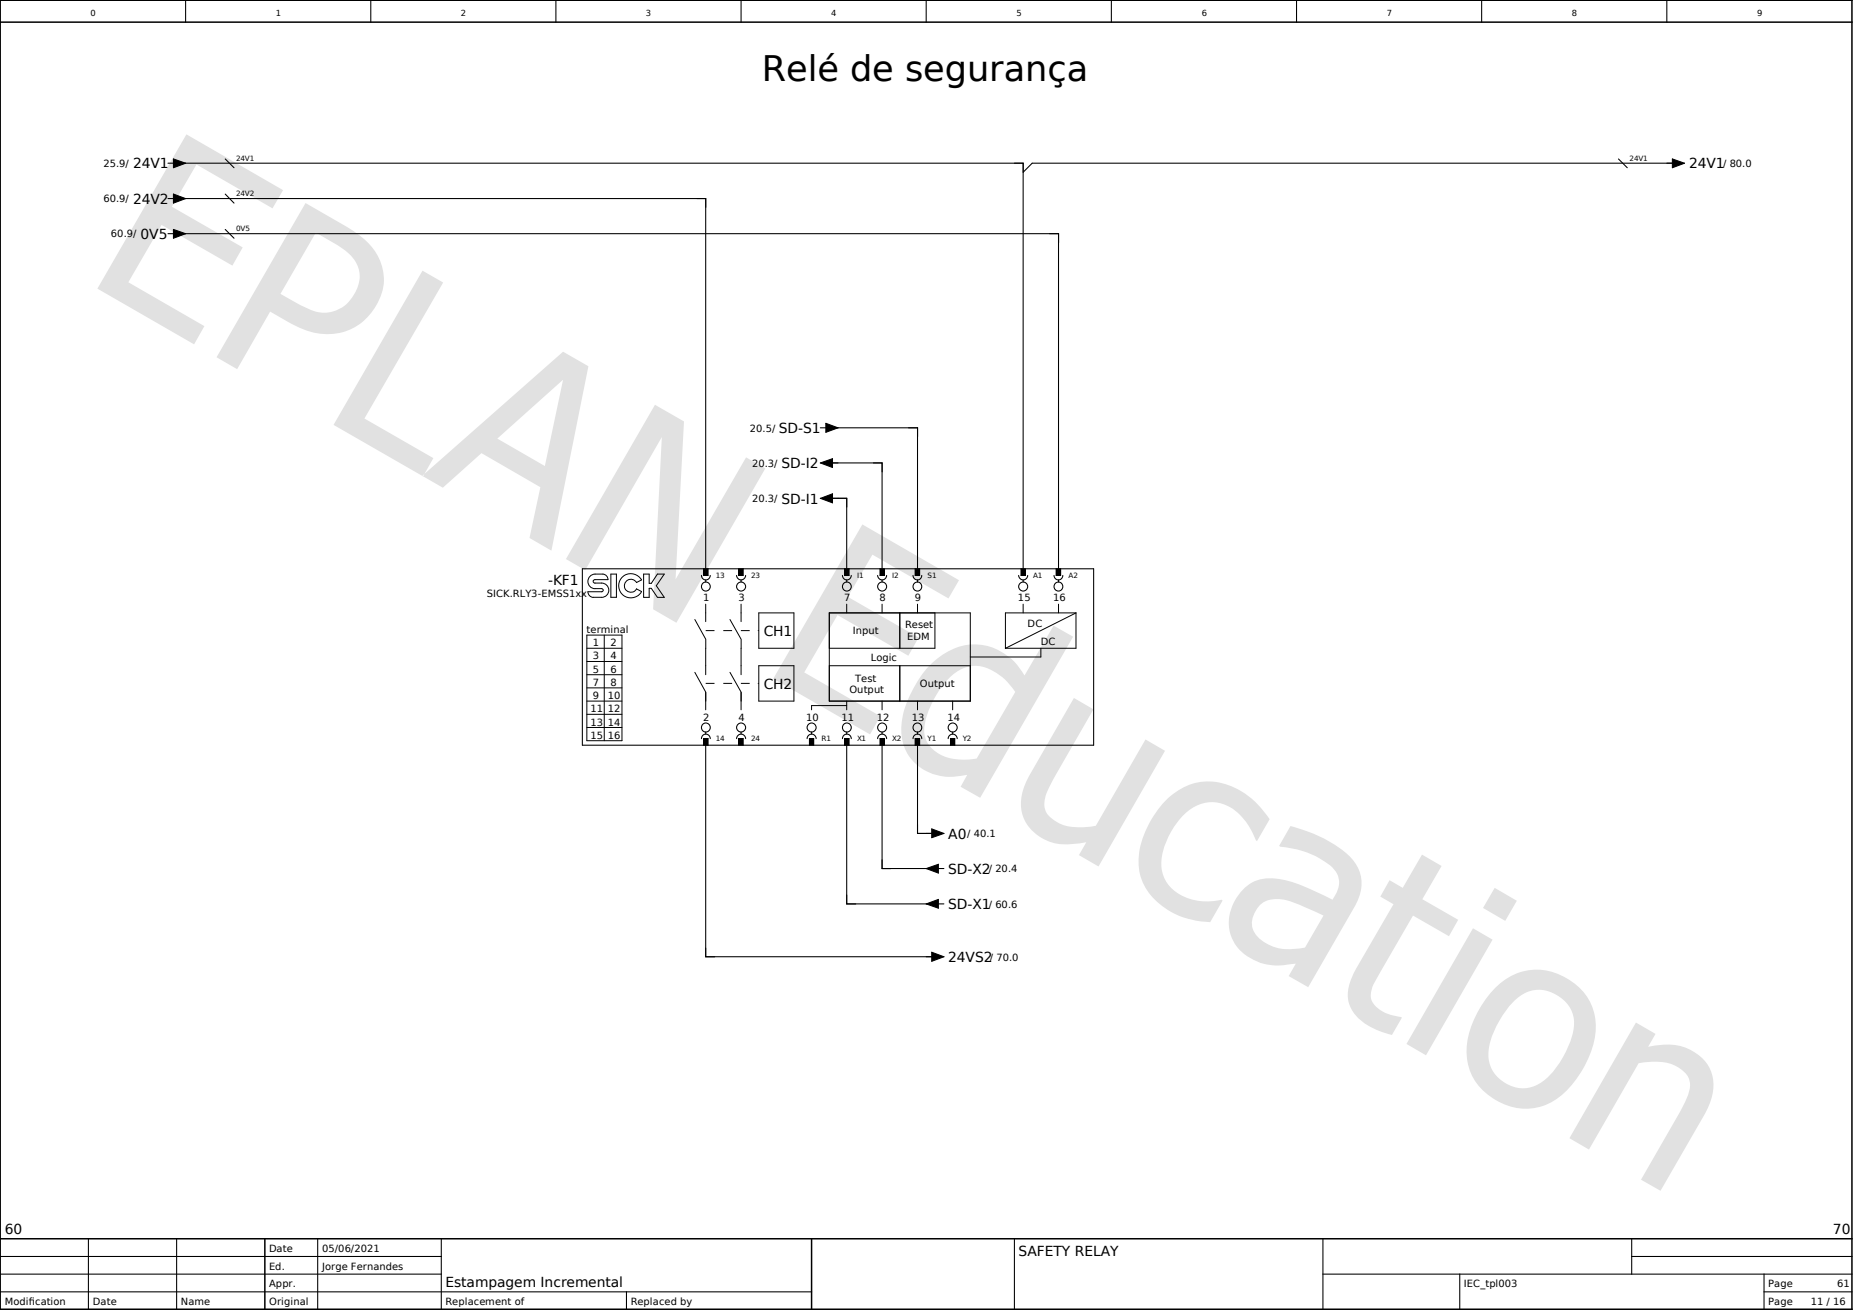
[picture p17: page 15]
SAFETY RELAY; Logic; Reset EDM; Output Test Output; Input; terminal; SICK.RLY3-EMSS1xx

9 | 10
11 | 12 | 10 11 12 13 14 R1 X1 X2 Y1 Y2
13 | 14
15 | 16

# Ativação e controlo

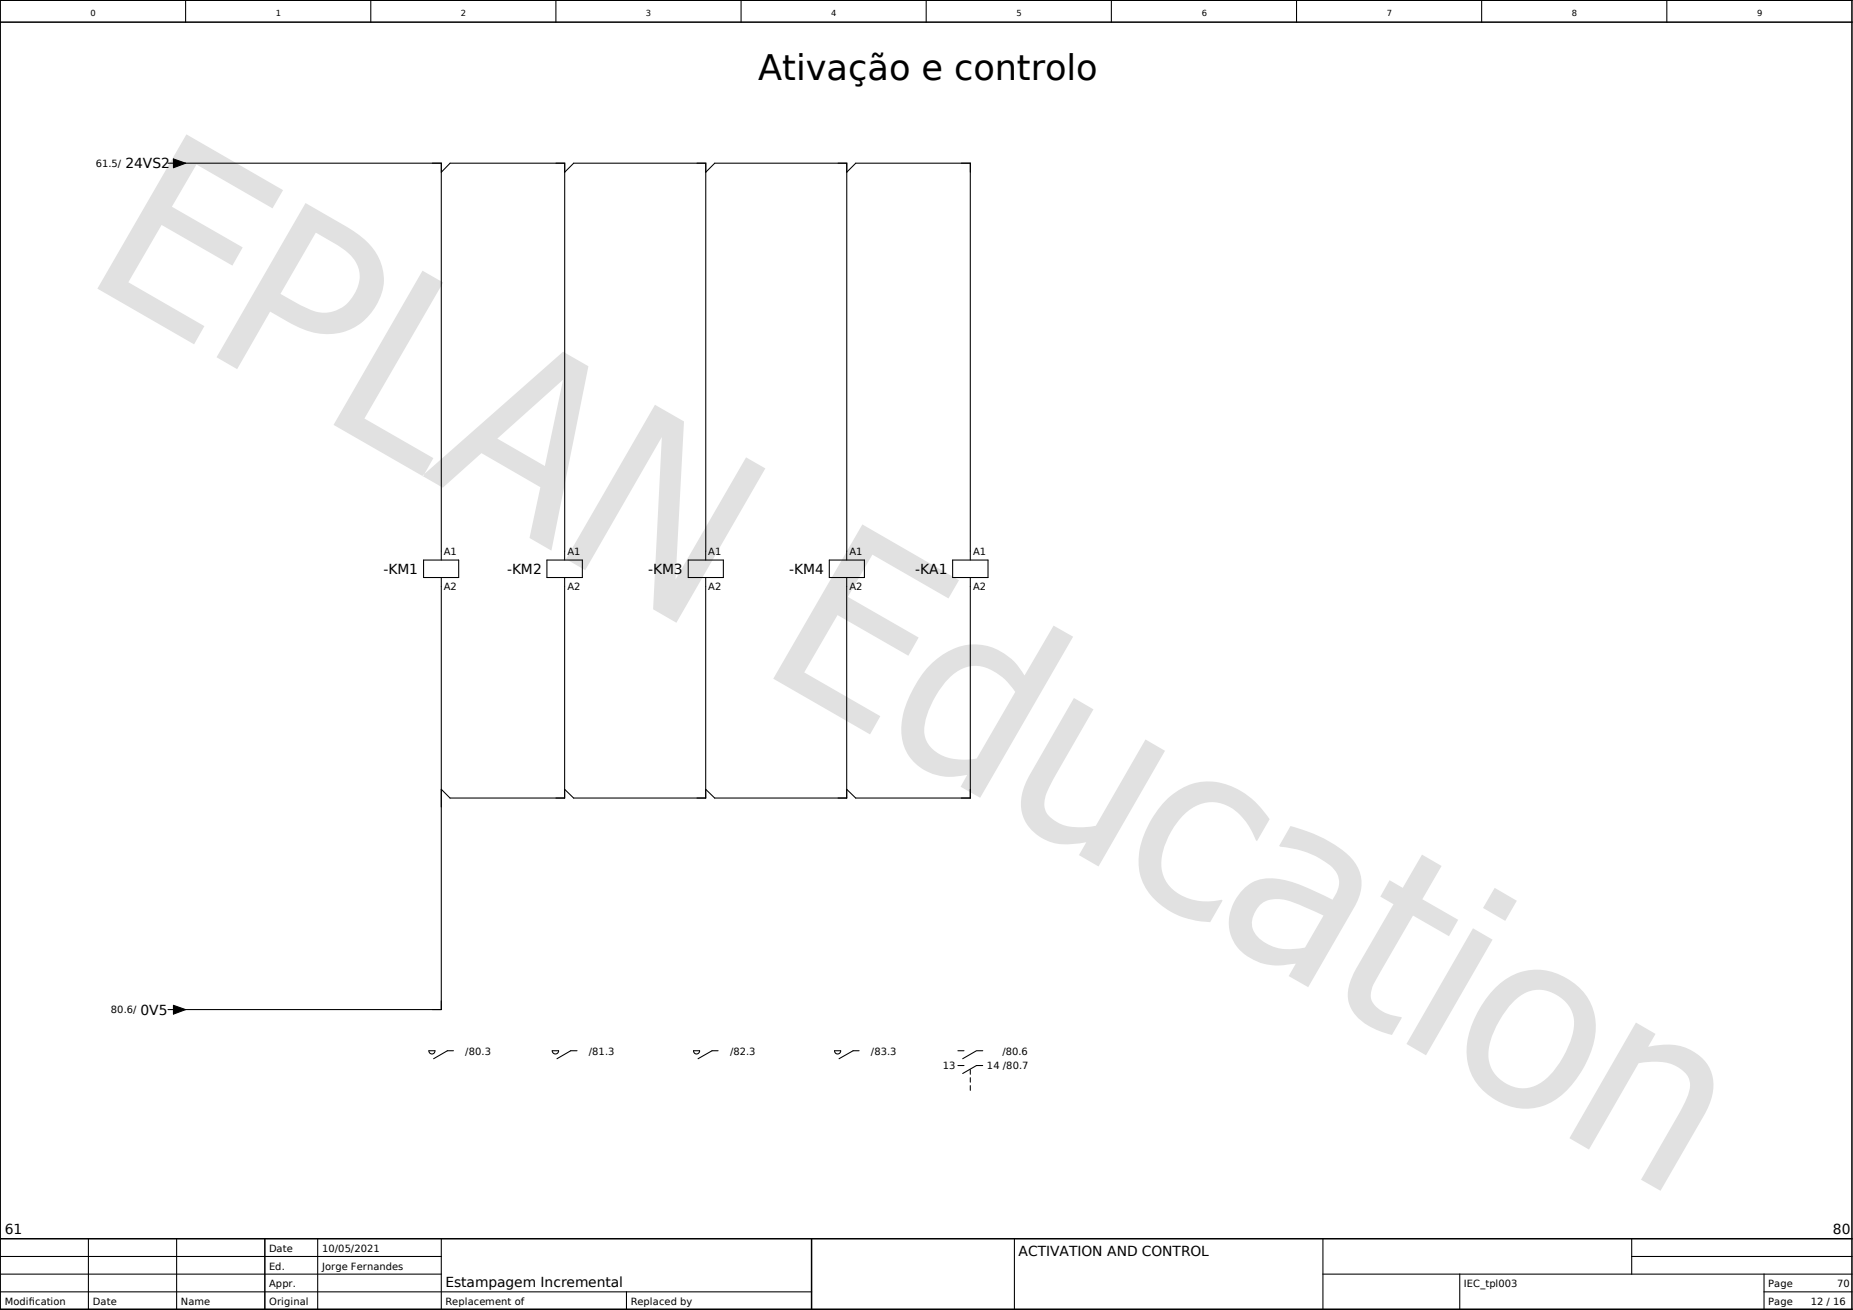
[picture p18: page 16]

ACTIVATION AND CONTROL

D0

D1

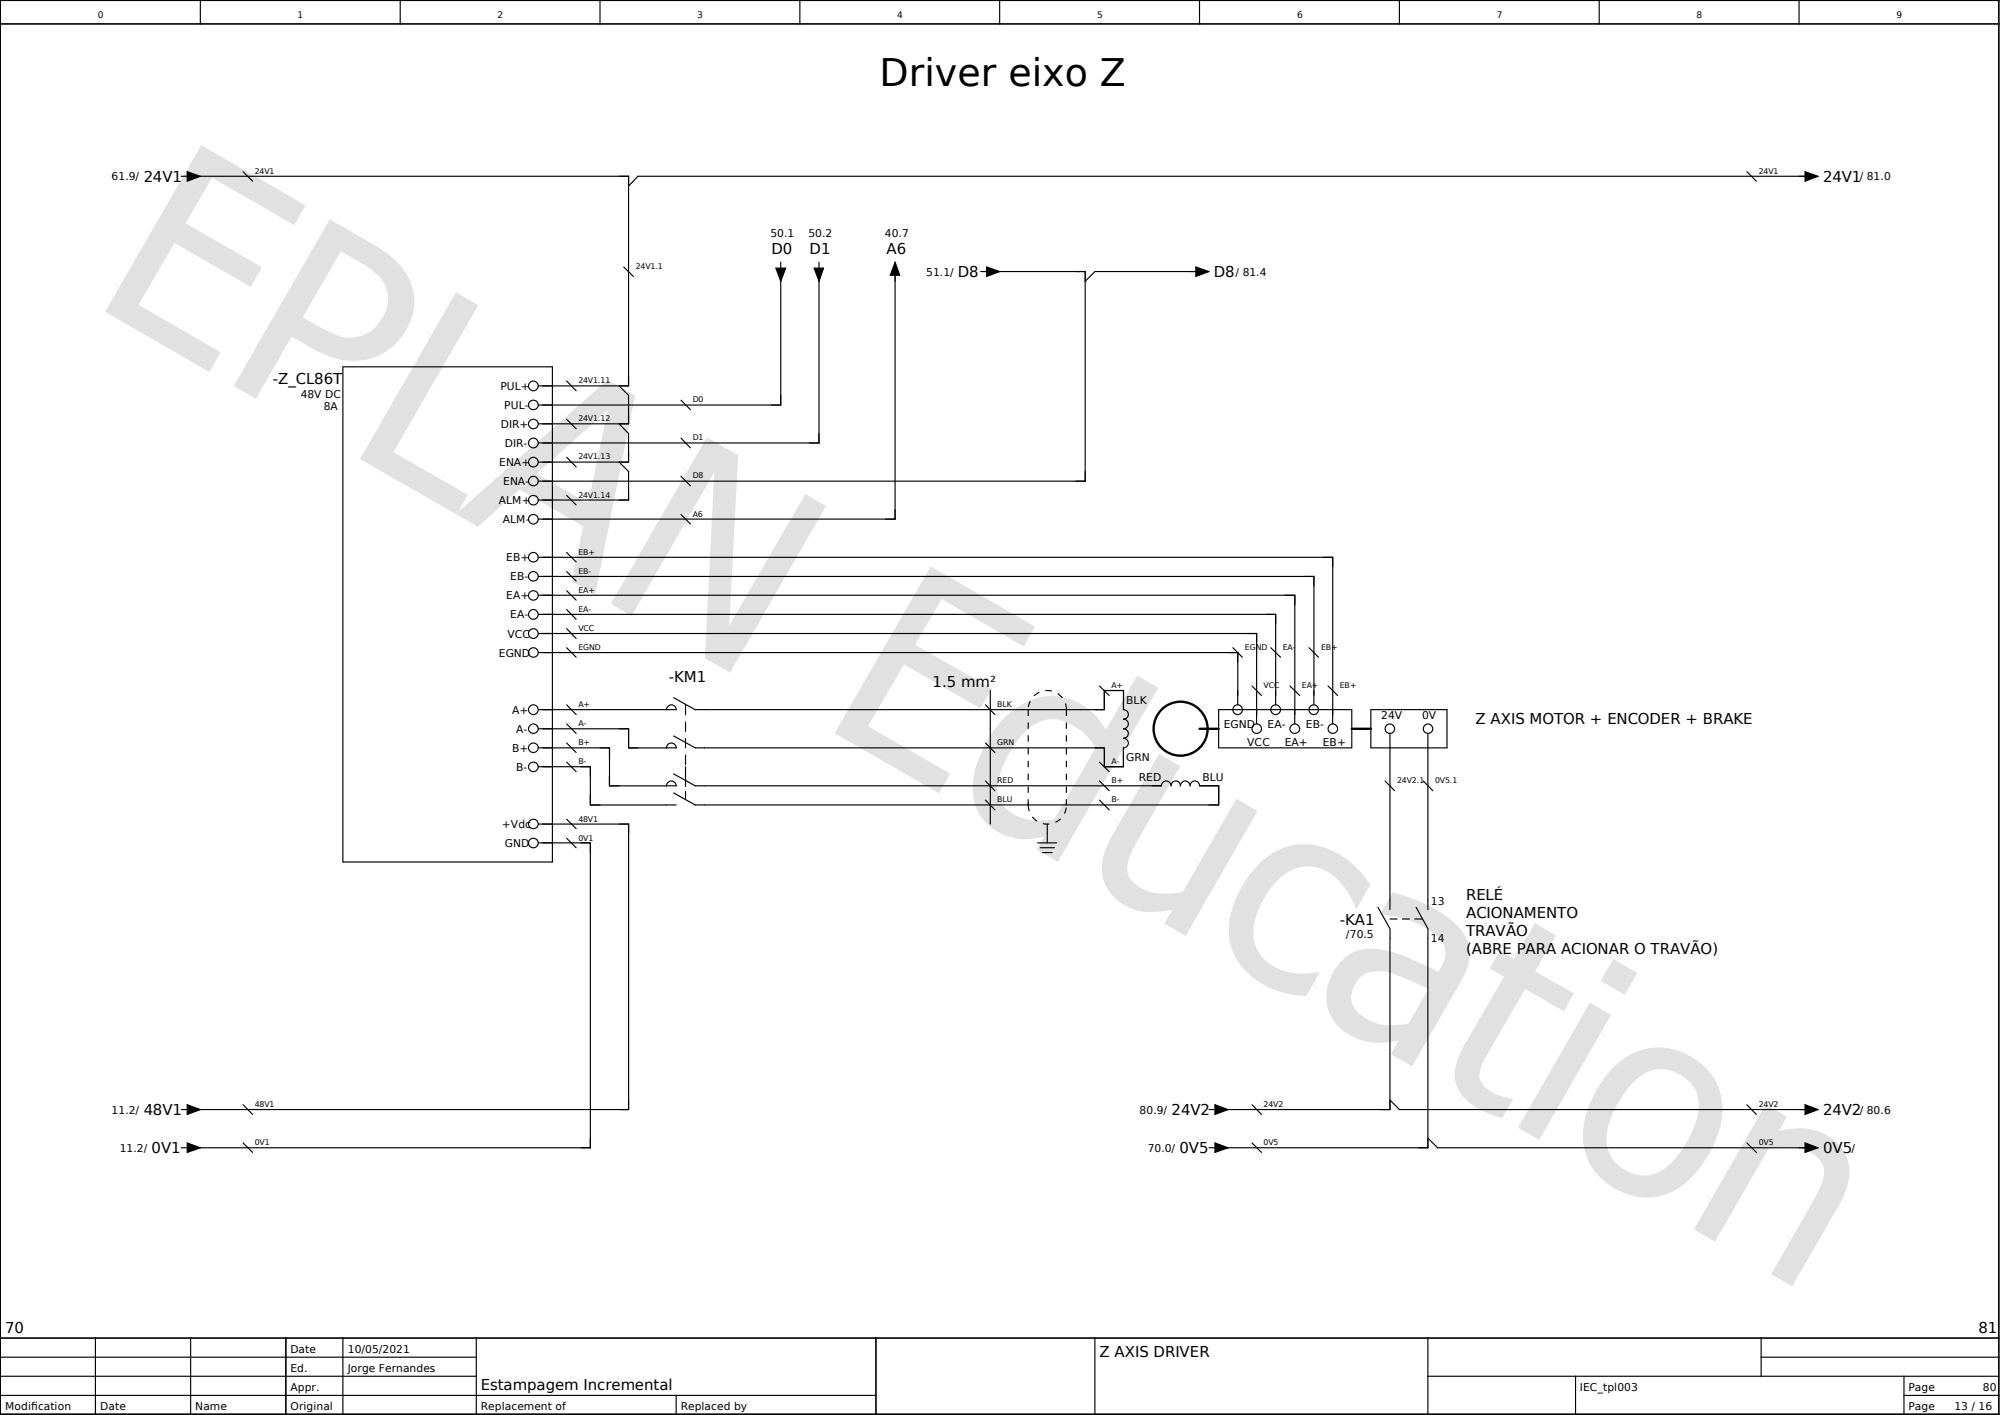
[picture p19: page 17]
Z AXIS DRIVER; RELÉ ACIONAMENTO TRAVÃO (ABRE PARA ACIONAR O TRAVÃO); PUL+; PUL-; DIR+; DIR-; ENA+; ENA-; ALM+; ALM-; VCC; EGND; +Vdc; GND; BLK; GRN; RED; BLU; 1.5 mm²; Driver eixo Z

Z AXIS MOTOR + ENCODER + BRAKE

D2

D3

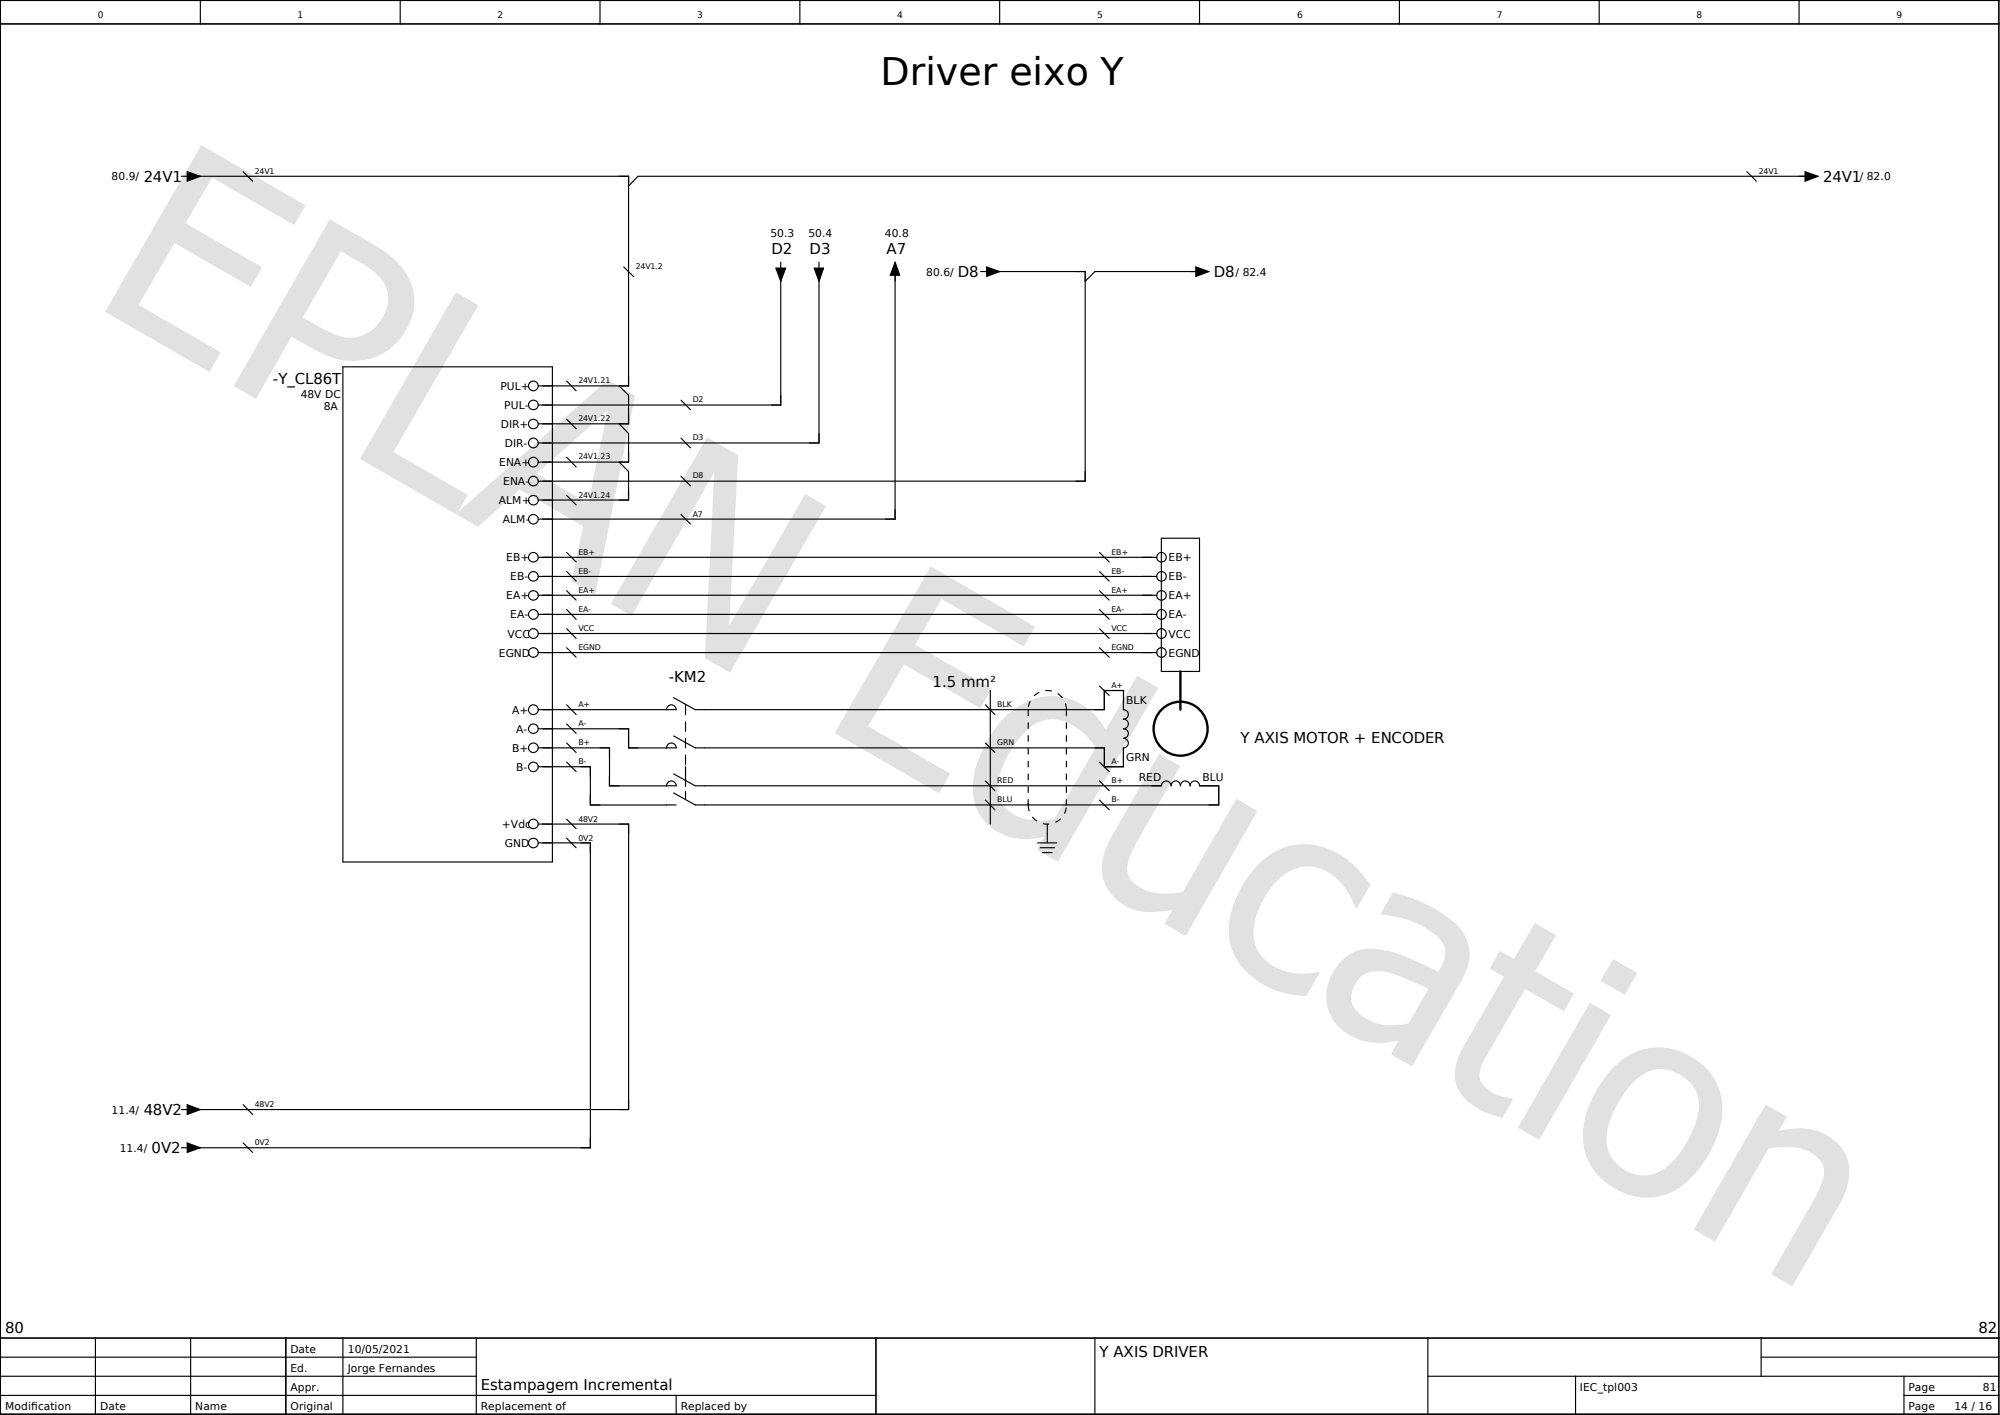
[picture p20: page 18]
Y AXIS DRIVER; PUL+; PUL-; DIR+; DIR-; ENA+; ENA-; ALM+; ALM-; VCC; EGND; +Vdc; GND; BLK; GRN; RED; BLU; 1.5 mm²; Driver eixo Y

Y AXIS MOTOR + ENCODER

D4

D5

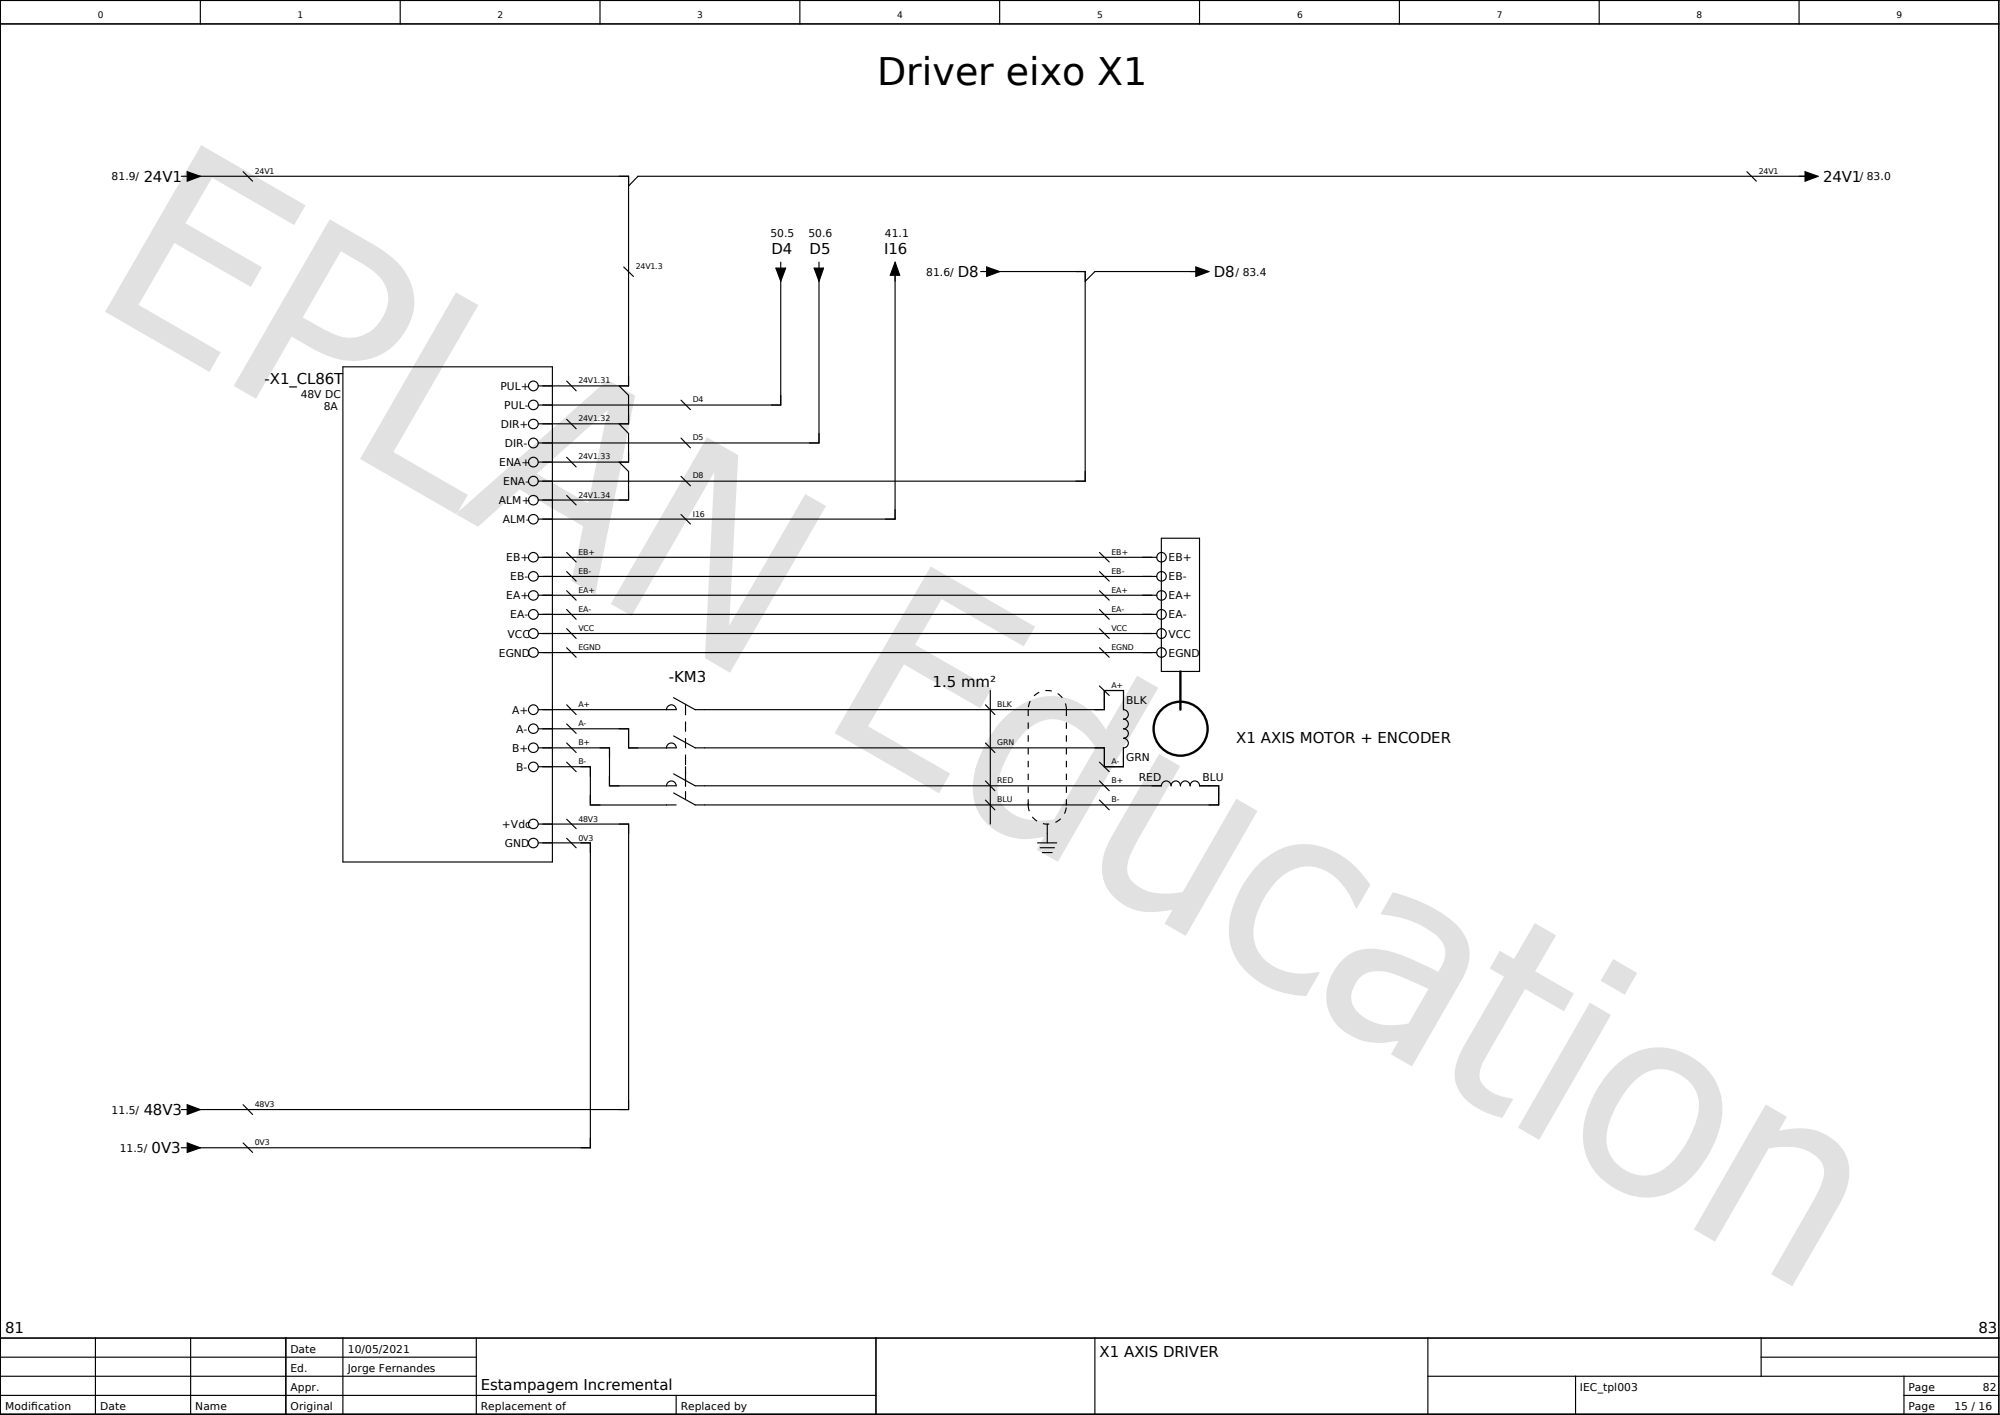
[picture p21: page 19]
X1 AXIS DRIVER; PUL+; PUL-; DIR+; DIR-; ENA+; ENA-; ALM+; ALM-; VCC; EGND; +Vdc; GND; BLK; GRN; RED; BLU; 1.5 mm²; Driver eixo X1

X1 AXIS MOTOR + ENCODER

D6

D7

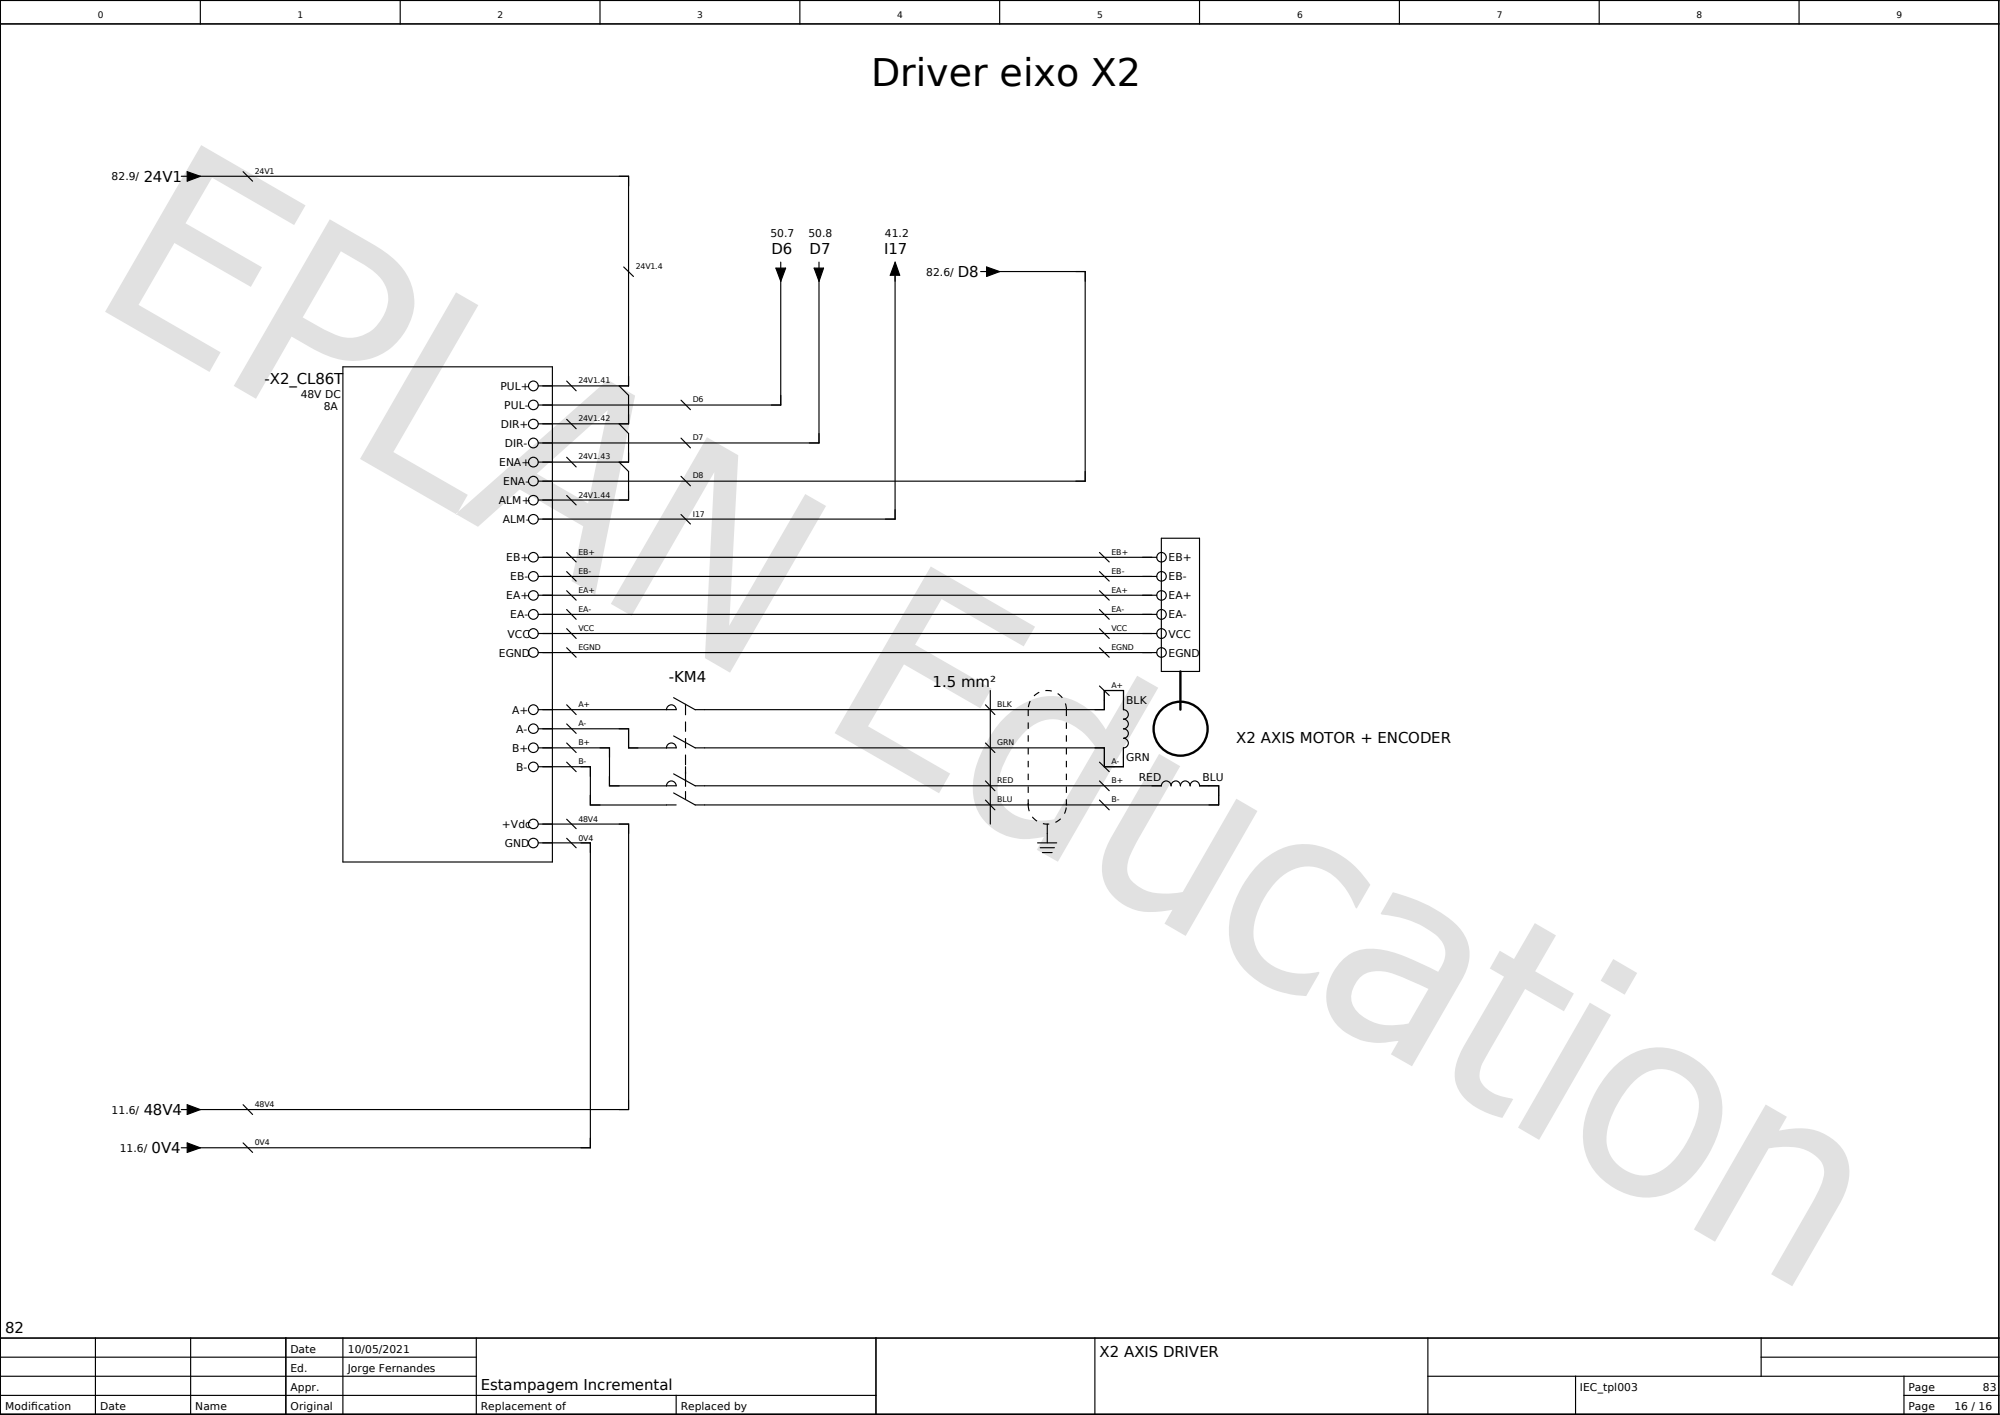
[picture p22: page 20]
X2 AXIS DRIVER; PUL+; PUL-; DIR+; DIR-; ENA+; ENA-; ALM+; ALM-; VCC; EGND; +Vdc; GND; BLK; GRN; RED; BLU; 1.5 mm²; Driver eixo X2

X2 AXIS MOTOR + ENCODER
