JorgeFernandes-Git/ISFM/(commit log)

2021-07-10 Create Enclosure_CAD
2021-07-10 Update Enclosure_CAD
